ABMicrowaves/Project_1410/(list of files, drawings)

Other design files:
schematics/BA1410RX10R3_2.DSN
schematics/SOQPSK_TX_BB_A0P28.DSN
