ABMicrowaves/Project_1410/BA-BS-TLAB-DUALv-1.6/PIC18F24K22_registers.h

#byte TOSU = 0xFFF
#word TOS = 0xFFE
#byte STKPTR = 0xFFC
#bit    STKPTR0 = STKPTR.0
#bit    STKPTR1 = STKPTR.1
#bit    STKPTR2 = STKPTR.2
#bit    STKPTR3 = STKPTR.3
#bit    STKPTR4 = STKPTR.4
#bit    STKUNF = STKPTR.6
#bit    STKFUL = STKPTR.7
#byte PCLATU = 0xFFB
#byte PCLATH = 0xFFA
#byte PCL = 0xFF9
#byte TBLPTRU = 0xFF8
#word TBLPTR = 0xFF7
#byte TABLAT = 0xFF5
#word PROD = 0xFF4
#byte INTCON = 0xFF2
#bit    RBIF = INTCON.0
#bit    INT0IF = INTCON.1
#bit    TMR0IF = INTCON.2
#bit    RBIE = INTCON.3
#bit    INT0IE = INTCON.4
#bit    TMR0IE = INTCON.5
#bit    PEIE_GIEL = INTCON.6
#bit    GIE_GIEH = INTCON.7
#byte INTCON2 = 0xFF1
#bit    RBIP = INTCON2.0
#bit    TMR0IP = INTCON2.2
#bit    INTEDG2 = INTCON2.4
#bit    INTEDG1 = INTCON2.5
#bit    INTEDG0 = INTCON2.6
#bit    RBPU = INTCON2.7
#byte INTCON3 = 0xFF0
#bit    INT1IF = INTCON3.0
#bit    INT2IF = INTCON3.1
#bit    INT1IE = INTCON3.3
#bit    INT2IE = INTCON3.4
#bit    INT1IP = INTCON3.6
#bit    INT2IP = INTCON3.7
#byte INDF0 = 0xFEF
#byte POSTINC0 = 0xFEE
#byte POSTDEC0 = 0xFED
#byte PREINC0 = 0xFEC
#byte PLUSW0 = 0xFEB
#word FSR0 = 0xFEA
#byte WREG = 0xFE8
#byte INDF1 = 0xFE7
#byte POSTINC1 = 0xFE6
#byte POSTDEC1 = 0xFE5
#byte PREINC1 = 0xFE4
#byte PLUSW1 = 0xFE3
#word FSR1 = 0xFE2
#byte BSR = 0xFE0
#byte INDF2 = 0xFDF
#byte POSTINC2 = 0xFDE
#byte POSTDEC2 = 0xFDD
#byte PREINC2 = 0xFDC
#byte PLUSW2 = 0xFDB
#word FSR2 = 0xFDA
#byte STATUS = 0xFD8
#bit    C = STATUS.0
#bit    DC = STATUS.1
#bit    Z = STATUS.2
#bit    OV = STATUS.3
#bit    N = STATUS.4
#word TMR0 = 0xFD7
#byte T0CON = 0xFD5
#bit    T0PS0 = T0CON.0
#bit    T0PS1 = T0CON.1
#bit    T0PS2 = T0CON.2
#bit    PSA = T0CON.3
#bit    T0SE = T0CON.4
#bit    T0CS = T0CON.5
#bit    T08BIT = T0CON.6
#bit    TMR0ON = T0CON.7
#byte OSCCON = 0xFD3
#bit    SCS0 = OSCCON.0
#bit    SCS1 = OSCCON.1
#bit    HFIOFS = OSCCON.2
#bit    OSTS = OSCCON.3
#bit    IRCF0 = OSCCON.4
#bit    IRCF1 = OSCCON.5
#bit    IRCF2 = OSCCON.6
#bit    IDLEN = OSCCON.7
#byte OSCCON2 = 0xFD2
#bit    LFIOFS = OSCCON2.0
#bit    MFIOFS = OSCCON2.1
#bit    PRISD = OSCCON2.2
#bit    SOSCGO = OSCCON2.3
#bit    MFIOSEL = OSCCON2.4
#bit    SOSCRUN = OSCCON2.6
#bit    PLLRDY = OSCCON2.7
#byte WDTCON = 0xFD1
#bit    SWDTEN = WDTCON.0
#byte RCON = 0xFD0
#bit    BOR = RCON.0
#bit    POR = RCON.1
#bit    PD = RCON.2
#bit    TO = RCON.3
#bit    RI = RCON.4
#bit    SBOREN = RCON.6
#bit    IPEN = RCON.7
#word TMR1 = 0xFCF
#byte T1CON = 0xFCD
#bit    TMR1ON = T1CON.0
#bit    T1RD16 = T1CON.1
#bit    T1SYNC = T1CON.2
#bit    T1SOSCEN = T1CON.3
#bit    T1CKPS0 = T1CON.4
#bit    T1CKPS1 = T1CON.5
#bit    TMR1CS0 = T1CON.6
#bit    TMR1CS1 = T1CON.7
#byte T1GCON = 0xFCC
#bit    T1GSS0 = T1GCON.0
#bit    T1GSS1 = T1GCON.1
#bit    T1GVAL = T1GCON.2
#bit    T1GGO = T1GCON.3
#bit    T1GSPM = T1GCON.4
#bit    T1GTM = T1GCON.5
#bit    T1GPOL = T1GCON.6
#bit    TMR1GE = T1GCON.7
#byte SSP1CON3 = 0xFCB
#bit    SSP1DHEN = SSP1CON3.0
#bit    SSP1AHEN = SSP1CON3.1
#bit    SSP1SBCDE = SSP1CON3.2
#bit    SSP1SDAHT = SSP1CON3.3
#bit    SSP1BOEN = SSP1CON3.4
#bit    SSP1SCIE = SSP1CON3.5
#bit    SSP1PCIE = SSP1CON3.6
#bit    SSP1ACKTIM = SSP1CON3.7
#byte SSP1MSK = 0xFCA
#byte SSP1BUF = 0xFC9
#byte SSP1ADD = 0xFC8
#byte SSP1STAT = 0xFC7
#bit    SSP1BF = SSP1STAT.0
#bit    SSP1UA = SSP1STAT.1
#bit    SSP1R = SSP1STAT.2
#bit    SSP1S = SSP1STAT.3
#bit    SSP1P = SSP1STAT.4
#bit    SSP1D = SSP1STAT.5
#bit    SSP1CKE = SSP1STAT.6
#bit    SSP1SMP = SSP1STAT.7
#byte SSP1CON1 = 0xFC6
#bit    SSP1M0 = SSP1CON1.0
#bit    SSP1M1 = SSP1CON1.1
#bit    SSP1M2 = SSP1CON1.2
#bit    SSP1M3 = SSP1CON1.3
#bit    SSP1CKP = SSP1CON1.4
#bit    SSP1EN = SSP1CON1.5
#bit    SSP1OV = SSP1CON1.6
#bit    SSP1WCOL = SSP1CON1.7
#byte SSP1CON2 = 0xFC5
#bit    SSP1SEN = SSP1CON2.0
#bit    SSP1RSEN = SSP1CON2.1
#bit    SSP1PEN = SSP1CON2.2
#bit    SSP1RCEN = SSP1CON2.3
#bit    SSP1ACKEN = SSP1CON2.4
#bit    SSP1ACKDT = SSP1CON2.5
#bit    SSP1ACKSTAT = SSP1CON2.6
#bit    SSP1GCEN = SSP1CON2.7
#word ADRES = 0xFC4
#byte ADCON0 = 0xFC2
#bit    ADON = ADCON0.0
#bit    GO = ADCON0.1
#bit    CHS0 = ADCON0.2
#bit    CHS1 = ADCON0.3
#bit    CHS2 = ADCON0.4
#bit    CHS3 = ADCON0.5
#bit    CHS4 = ADCON0.6
#byte ADCON1 = 0xFC1
#bit    NVCFG0 = ADCON1.0
#bit    NVCFG1 = ADCON1.1
#bit    PVCFG0 = ADCON1.2
#bit    PVCFG1 = ADCON1.3
#bit    TRIGSEL = ADCON1.7
#byte ADCON2 = 0xFC0
#bit    ADCS0 = ADCON2.0
#bit    ADCS1 = ADCON2.1
#bit    ADCS2 = ADCON2.2
#bit    ACQT0 = ADCON2.3
#bit    ACQT1 = ADCON2.4
#bit    ACQT2 = ADCON2.5
#bit    ADFM = ADCON2.7
#word CCPR1 = 0xFBF
#byte CCP1CON = 0xFBD
#bit    CCP1M0 = CCP1CON.0
#bit    CCP1M1 = CCP1CON.1
#bit    CCP1M2 = CCP1CON.2
#bit    CCP1M3 = CCP1CON.3
#bit    DC1B0 = CCP1CON.4
#bit    DC1B1 = CCP1CON.5
#bit    P1M0 = CCP1CON.6
#bit    P1M1 = CCP1CON.7
#byte TMR2 = 0xFBC
#byte PR2 = 0xFBB
#byte T2CON = 0xFBA
#bit    T2CKPS0 = T2CON.0
#bit    T2CKPS1 = T2CON.1
#bit    TMR2ON = T2CON.2
#bit    T2OUTPS0 = T2CON.3
#bit    T2OUTPS1 = T2CON.4
#bit    T2OUTPS2 = T2CON.5
#bit    T2OUTPS3 = T2CON.6
#byte PSTR1CON = 0xFB9
#bit    STR1A = PSTR1CON.0
#bit    STR1B = PSTR1CON.1
#bit    STR1C = PSTR1CON.2
#bit    STR1D = PSTR1CON.3
#bit    STR1SYNC = PSTR1CON.4
#byte BAUDCON1 = 0xFB8
#bit    ABDEN1 = BAUDCON1.0
#bit    WUE1 = BAUDCON1.1
#bit    BRG161 = BAUDCON1.3
#bit    CKTXP1 = BAUDCON1.4
#bit    DTRXP1 = BAUDCON1.5
#bit    RCIDL1 = BAUDCON1.6
#bit    ABDOVF1 = BAUDCON1.7
#byte PWM1CON = 0xFB7
#bit    P1DC0 = PWM1CON.0
#bit    P1DC1 = PWM1CON.1
#bit    P1DC2 = PWM1CON.2
#bit    P1DC3 = PWM1CON.3
#bit    P1DC4 = PWM1CON.4
#bit    P1DC5 = PWM1CON.5
#bit    P1DC6 = PWM1CON.6
#bit    P1RSEN = PWM1CON.7
#byte ECCP1AS = 0xFB6
#bit    PSS1BD0 = ECCP1AS.0
#bit    PSS1BD1 = ECCP1AS.1
#bit    PSS1AC0 = ECCP1AS.2
#bit    PSS1AC1 = ECCP1AS.3
#bit    CCP1AS0 = ECCP1AS.4
#bit    CCP1AS1 = ECCP1AS.5
#bit    CCP1AS2 = ECCP1AS.6
#bit    CCP1ASE = ECCP1AS.7
#byte T3GCON = 0xFB4
#bit    T3GSS0 = T3GCON.0
#bit    T3GSS1 = T3GCON.1
#bit    T3GVAL = T3GCON.2
#bit    T3GGO = T3GCON.3
#bit    T3GSPM = T3GCON.4
#bit    T3GTM = T3GCON.5
#bit    T3GPOL = T3GCON.6
#bit    TMR3GE = T3GCON.7
#word TMR3 = 0xFB3
#byte T3CON = 0xFB1
#bit    TMR3ON = T3CON.0
#bit    T3RD16 = T3CON.1
#bit    T3SYNC = T3CON.2
#bit    T3SOSCEN = T3CON.3
#bit    T3CKPS0 = T3CON.4
#bit    T3CKPS1 = T3CON.5
#bit    TMR3CS0 = T3CON.6
#bit    TMR3CS1 = T3CON.7
#byte SPBRGH1 = 0xFB0
#byte SPBRG1 = 0xFAF
#byte RCREG1 = 0xFAE
#byte TXREG1 = 0xFAD
#byte TXSTA1 = 0xFAC
#bit    TX9D1 = TXSTA1.0
#bit    TRMT1 = TXSTA1.1
#bit    BRGH1 = TXSTA1.2
#bit    SENDB1 = TXSTA1.3
#bit    SYNC1 = TXSTA1.4
#bit    TXEN1 = TXSTA1.5
#bit    TX91 = TXSTA1.6
#bit    CSRC1 = TXSTA1.7
#byte RCSTA1 = 0xFAB
#bit    RX9D1 = RCSTA1.0
#bit    OERR1 = RCSTA1.1
#bit    FERR1 = RCSTA1.2
#bit    ADDEN1 = RCSTA1.3
#bit    CREN1 = RCSTA1.4
#bit    SREN1 = RCSTA1.5
#bit    RX91 = RCSTA1.6
#bit    SPEN1 = RCSTA1.7
#byte EEADR = 0xFA9
#byte EEDATA = 0xFA8
#byte EECON2 = 0xFA7
#byte EECON1 = 0xFA6
#bit    RD = EECON1.0
#bit    WR = EECON1.1
#bit    WREN = EECON1.2
#bit    WRERR = EECON1.3
#bit    FREE = EECON1.4
#bit    CFGS = EECON1.6
#bit    EEPGD = EECON1.7
#byte IPR3 = 0xFA5
#bit    TMR1GIP = IPR3.0
#bit    TMR3GIP = IPR3.1
#bit    TMR5GIP = IPR3.2
#bit    CTMUIP = IPR3.3
#bit    TX2IP = IPR3.4
#bit    RC2IP = IPR3.5
#bit    BCL2IP = IPR3.6
#bit    SSP2IP = IPR3.7
#byte PIR3 = 0xFA4
#bit    TMR1GIF = PIR3.0
#bit    TMR3GIF = PIR3.1
#bit    TMR5GIF = PIR3.2
#bit    CTMUIF = PIR3.3
#bit    TX2IF = PIR3.4
#bit    RC2IF = PIR3.5
#bit    BCL2IF = PIR3.6
#bit    SSP2IF = PIR3.7
#byte PIE3 = 0xFA3
#bit    TMR1GIE = PIE3.0
#bit    TMR3GIE = PIE3.1
#bit    TMR5GIE = PIE3.2
#bit    CTMUIE = PIE3.3
#bit    TX2IE = PIE3.4
#bit    RC2IE = PIE3.5
#bit    BCL2IE = PIE3.6
#bit    SSP2IE = PIE3.7
#byte IPR2 = 0xFA2
#bit    CCP2IP = IPR2.0
#bit    TMR3IP = IPR2.1
#bit    HLVDIP = IPR2.2
#bit    BCL1IP = IPR2.3
#bit    EEIP = IPR2.4
#bit    C2IP = IPR2.5
#bit    C1IP = IPR2.6
#bit    OSCFIP = IPR2.7
#byte PIR2 = 0xFA1
#bit    CCP2IF = PIR2.0
#bit    TMR3IF = PIR2.1
#bit    HLVDIF = PIR2.2
#bit    BCL1IF = PIR2.3
#bit    EEIF = PIR2.4
#bit    C2IF = PIR2.5
#bit    C1IF = PIR2.6
#bit    OSCFIF = PIR2.7
#byte PIE2 = 0xFA0
#bit    CCP2IE = PIE2.0
#bit    TMR3IE = PIE2.1
#bit    HLVDIE = PIE2.2
#bit    BCL1IE = PIE2.3
#bit    EEIE = PIE2.4
#bit    C2IE = PIE2.5
#bit    C1IE = PIE2.6
#bit    OSCFIE = PIE2.7
#byte IPR1 = 0xF9F
#bit    TMR1IP = IPR1.0
#bit    TMR2IP = IPR1.1
#bit    CCP1IP = IPR1.2
#bit    SSP1IP = IPR1.3
#bit    TX1IP = IPR1.4
#bit    RC1IP = IPR1.5
#bit    ADIP = IPR1.6
#byte PIR1 = 0xF9E
#bit    TMR1IF = PIR1.0
#bit    TMR2IF = PIR1.1
#bit    CCP1IF = PIR1.2
#bit    SSP1IF = PIR1.3
#bit    TX1IF = PIR1.4
#bit    RC1IF = PIR1.5
#bit    ADIF = PIR1.6
#byte PIE1 = 0xF9D
#bit    TMR1IE = PIE1.0
#bit    TMR2IE = PIE1.1
#bit    CCP1IE = PIE1.2
#bit    SSP1IE = PIE1.3
#bit    TX1IE = PIE1.4
#bit    RC1IE = PIE1.5
#bit    ADIE = PIE1.6
#byte HLVDCON = 0xF9C
#bit    HLVDL0 = HLVDCON.0
#bit    HLVDL1 = HLVDCON.1
#bit    HLVDL2 = HLVDCON.2
#bit    HLVDL3 = HLVDCON.3
#bit    HLVDEN = HLVDCON.4
#bit    IRVST = HLVDCON.5
#bit    BGVST = HLVDCON.6
#bit    VDIRMAG = HLVDCON.7
#byte OSCTUNE = 0xF9B
#bit    TUN0 = OSCTUNE.0
#bit    TUN1 = OSCTUNE.1
#bit    TUN2 = OSCTUNE.2
#bit    TUN3 = OSCTUNE.3
#bit    TUN4 = OSCTUNE.4
#bit    TUN5 = OSCTUNE.5
#bit    PLLEN = OSCTUNE.6
#bit    INTSRC = OSCTUNE.7
#byte TRISE = 0xF96
#bit    WPUE3 = TRISE.7
#byte TRISC = 0xF94
#byte TRISB = 0xF93
#byte TRISA = 0xF92
#byte LATC = 0xF8B
#byte LATB = 0xF8A
#byte LATA = 0xF89
#byte PORTE = 0xF84
#bit    RE3 = PORTE.3
#byte PORTC = 0xF82
#byte PORTB = 0xF81
#byte PORTA = 0xF80
#byte IPR5 = 0xF7F
#bit    TMR4IP = IPR5.0
#bit    TMR5IP = IPR5.1
#bit    TMR6IP = IPR5.2
#byte PIR5 = 0xF7E
#bit    TMR4IF = PIR5.0
#bit    TMR5IF = PIR5.1
#bit    TMR6IF = PIR5.2
#byte PIE5 = 0xF7D
#bit    TMR4IE = PIE5.0
#bit    TMR5IE = PIE5.1
#bit    TMR6IE = PIE5.2
#byte IPR4 = 0xF7C
#bit    CCP3IP = IPR4.0
#bit    CCP4IP = IPR4.1
#bit    CCP5IP = IPR4.2
#byte PIR4 = 0xF7B
#bit    CCP3IF = PIR4.0
#bit    CCP4IF = PIR4.1
#bit    CCP5IF = PIR4.2
#byte PIE4 = 0xF7A
#bit    CCP3IE = PIE4.0
#bit    CCP4IE = PIE4.1
#bit    CCP5IE = PIE4.2
#byte CM1CON0 = 0xF79
#bit    C1CH0 = CM1CON0.0
#bit    C1CH1 = CM1CON0.1
#bit    C1R = CM1CON0.2
#bit    C1SP = CM1CON0.3
#bit    C1POL = CM1CON0.4
#bit    C1OE = CM1CON0.5
//#bit    C1OUT = CM1CON0.6
#bit    C1ON = CM1CON0.7
#byte CM2CON0 = 0xF78
#bit    C2CH0 = CM2CON0.0
#bit    C2CH1 = CM2CON0.1
#bit    C2R = CM2CON0.2
#bit    C2SP = CM2CON0.3
#bit    C2POL = CM2CON0.4
#bit    C2OE = CM2CON0.5
//#bit    C2OUT = CM2CON0.6
#bit    C2ON = CM2CON0.7
#byte CM2CON1 = 0xF77
#bit    C2SYNC = CM2CON1.0
#bit    C1SYNC = CM2CON1.1
#bit    C2HYS = CM2CON1.2
#bit    C1HYS = CM2CON1.3
#bit    C2RSEL = CM2CON1.4
#bit    C1RSEL = CM2CON1.5
#bit    MC2OUT = CM2CON1.6
#bit    MC1OUT = CM2CON1.7
#byte SPBRGH2 = 0xF76
#byte SPBRG2 = 0xF75
#byte RCREG2 = 0xF74
#byte TXREG2 = 0xF73
#byte TXSTA2 = 0xF72
#bit    TX9D2 = TXSTA2.0
#bit    TRMT2 = TXSTA2.1
#bit    BRGH2 = TXSTA2.2
#bit    SENDB2 = TXSTA2.3
#bit    SYNC2 = TXSTA2.4
#bit    TXEN2 = TXSTA2.5
#bit    TX92 = TXSTA2.6
#bit    CSRC2 = TXSTA2.7
#byte RCSTA2 = 0xF71
#bit    RX9D2 = RCSTA2.0
#bit    OERR2 = RCSTA2.1
#bit    FERR2 = RCSTA2.2
#bit    ADDEN2 = RCSTA2.3
#bit    CREN2 = RCSTA2.4
#bit    SREN2 = RCSTA2.5
#bit    RX92 = RCSTA2.6
#bit    SPEN2 = RCSTA2.7
#byte BAUDCON2 = 0xF70
#bit    ABDEN2 = BAUDCON2.0
#bit    WUE2 = BAUDCON2.1
#bit    BRG162 = BAUDCON2.3
#bit    CKTXP2 = BAUDCON2.4
#bit    DTRXP2 = BAUDCON2.5
#bit    RCIDL2 = BAUDCON2.6
#bit    ABDOVF2 = BAUDCON2.7
#byte SSP2BUF = 0xF6F
#byte SSP2ADD = 0xF6E
#byte SSP2STAT = 0xF6D
#bit    SSP2BF = SSP2STAT.0
#bit    SSP2UA = SSP2STAT.1
#bit    SSP2R = SSP2STAT.2
#bit    SSP2S = SSP2STAT.3
#bit    SSP2P = SSP2STAT.4
#bit    SSP2D = SSP2STAT.5
#bit    SSP2CKE = SSP2STAT.6
#bit    SSP2SMP = SSP2STAT.7
#byte SSP2CON1 = 0xF6C
#bit    SSP2M0 = SSP2CON1.0
#bit    SSP2M1 = SSP2CON1.1
#bit    SSP2M2 = SSP2CON1.2
#bit    SSP2M3 = SSP2CON1.3
#bit    SSP2CKP = SSP2CON1.4
#bit    SSP2EN = SSP2CON1.5
#bit    SSP2OV = SSP2CON1.6
#bit    SSP2WCOL = SSP2CON1.7
#byte SSP2CON2 = 0xF6B
#bit    SSP2SEN = SSP2CON2.0
#bit    SSP2RSEN = SSP2CON2.1
#bit    SSP2PEN = SSP2CON2.2
#bit    SSP2RCEN = SSP2CON2.3
#bit    SSP2ACKEN = SSP2CON2.4
#bit    SSP2ACKDT = SSP2CON2.5
#bit    SSP2ACKSTAT = SSP2CON2.6
#bit    SSP2GCEN = SSP2CON2.7
#byte SSP2MSK = 0xF6A
#byte SSP2CON3 = 0xF69
#bit    SSP2DHEN = SSP2CON3.0
#bit    SSP2AHEN = SSP2CON3.1
#bit    SSP2SBCDE = SSP2CON3.2
#bit    SSP2SDAHT = SSP2CON3.3
#bit    SSP2BOEN = SSP2CON3.4
#bit    SSP2SCIE = SSP2CON3.5
#bit    SSP2PCIE = SSP2CON3.6
#bit    SSP2ACKTIM = SSP2CON3.7
#word CCPR2 = 0xF68
#byte CCP2CON = 0xF66
#bit    CCP2M0 = CCP2CON.0
#bit    CCP2M1 = CCP2CON.1
#bit    CCP2M2 = CCP2CON.2
#bit    CCP2M3 = CCP2CON.3
#bit    DC2B0 = CCP2CON.4
#bit    DC2B1 = CCP2CON.5
#bit    P2M0 = CCP2CON.6
#bit    P2M1 = CCP2CON.7
#byte PWM2CON = 0xF65
#bit    P2DC0 = PWM2CON.0
#bit    P2DC1 = PWM2CON.1
#bit    P2DC2 = PWM2CON.2
#bit    P2DC3 = PWM2CON.3
#bit    P2DC4 = PWM2CON.4
#bit    P2DC5 = PWM2CON.5
#bit    P2DC6 = PWM2CON.6
#bit    P2RSEN = PWM2CON.7
#byte ECCP2AS = 0xF64
#bit    PSS2BD0 = ECCP2AS.0
#bit    PSS2BD1 = ECCP2AS.1
#bit    PSS2AC0 = ECCP2AS.2
#bit    PSS2AC1 = ECCP2AS.3
#bit    CCP2AS0 = ECCP2AS.4
#bit    CCP2AS1 = ECCP2AS.5
#bit    CCP2AS2 = ECCP2AS.6
#bit    CCP2ASE = ECCP2AS.7
#byte PSTR2CON = 0xF63
#bit    STR2A = PSTR2CON.0
#bit    STR2B = PSTR2CON.1
#bit    STR2C = PSTR2CON.2
#bit    STR2D = PSTR2CON.3
#bit    STR2SYNC = PSTR2CON.4
#byte IOCB = 0xF62
#bit    IOCB4 = IOCB.4
#bit    IOCB5 = IOCB.5
#bit    IOCB6 = IOCB.6
#bit    IOCB7 = IOCB.7
#byte WPUB = 0xF61
#byte SLRCON = 0xF60
#bit    SLRA = SLRCON.0
#bit    SLRB = SLRCON.1
#bit    SLRC = SLRCON.2
#word CCPR3 = 0xF5F
#byte CCP3CON = 0xF5D
#bit    CCP3M0 = CCP3CON.0
#bit    CCP3M1 = CCP3CON.1
#bit    CCP3M2 = CCP3CON.2
#bit    CCP3M3 = CCP3CON.3
#bit    DC3B0 = CCP3CON.4
#bit    DC3B1 = CCP3CON.5
#bit    P3M0 = CCP3CON.6
#bit    P3M1 = CCP3CON.7
#byte PWM3CON = 0xF5C
#bit    P3DC0 = PWM3CON.0
#bit    P3DC1 = PWM3CON.1
#bit    P3DC2 = PWM3CON.2
#bit    P3DC3 = PWM3CON.3
#bit    P3DC4 = PWM3CON.4
#bit    P3DC5 = PWM3CON.5
#bit    P3DC6 = PWM3CON.6
#bit    P3RSEN = PWM3CON.7
#byte ECCP3AS = 0xF5B
#bit    PSS3BD0 = ECCP3AS.0
#bit    PSS3BD1 = ECCP3AS.1
#bit    PSS3AC0 = ECCP3AS.2
#bit    PSS3AC1 = ECCP3AS.3
#bit    CCP3AS0 = ECCP3AS.4
#bit    CCP3AS1 = ECCP3AS.5
#bit    CCP3AS2 = ECCP3AS.6
#bit    CCP3ASE = ECCP3AS.7
#byte PSTR3CON = 0xF5A
#bit    STR3A = PSTR3CON.0
#bit    STR3B = PSTR3CON.1
#bit    STR3C = PSTR3CON.2
#bit    STR3D = PSTR3CON.3
#bit    STR3SYNC = PSTR3CON.4
#word CCPR4 = 0xF59
#byte CCP4CON = 0xF57
#bit    CCP4M0 = CCP4CON.0
#bit    CCP4M1 = CCP4CON.1
#bit    CCP4M2 = CCP4CON.2
#bit    CCP4M3 = CCP4CON.3
#bit    DC4B0 = CCP4CON.4
#bit    DC4B1 = CCP4CON.5
#word CCPR5 = 0xF56
#byte CCP5CON = 0xF54
#bit    CCP5M0 = CCP5CON.0
#bit    CCP5M1 = CCP5CON.1
#bit    CCP5M2 = CCP5CON.2
#bit    CCP5M3 = CCP5CON.3
#bit    DC5B0 = CCP5CON.4
#bit    DC5B1 = CCP5CON.5
#byte TMR4 = 0xF53
#byte PR4 = 0xF52
#byte T4CON = 0xF51
#bit    T4CKPS0 = T4CON.0
#bit    T4CKPS1 = T4CON.1
#bit    TMR4ON = T4CON.2
#bit    T4OUTPS0 = T4CON.3
#bit    T4OUTPS1 = T4CON.4
#bit    T4OUTPS2 = T4CON.5
#bit    T4OUTPS3 = T4CON.6
#word TMR5 = 0xF50
#byte T5CON = 0xF4E
#bit    TMR5ON = T5CON.0
#bit    T5RD16 = T5CON.1
#bit    T5SYNC = T5CON.2
#bit    T5SOSCEN = T5CON.3
#bit    T5CKPS0 = T5CON.4
#bit    T5CKPS1 = T5CON.5
#bit    TMR5CS0 = T5CON.6
#bit    TMR5CS1 = T5CON.7
#byte T5GCON = 0xF4D
#bit    T5GSS0 = T5GCON.0
#bit    T5GSS1 = T5GCON.1
#bit    T5GVAL = T5GCON.2
#bit    T5GGO = T5GCON.3
#bit    T5GSPM = T5GCON.4
#bit    T5GTM = T5GCON.5
#bit    T5GPOL = T5GCON.6
#bit    TMR5GE = T5GCON.7
#byte TMR6 = 0xF4C
#byte PR6 = 0xF4B
#byte T6CON = 0xF4A
#bit    T6CKPS0 = T6CON.0
#bit    T6CKPS1 = T6CON.1
#bit    TMR6ON = T6CON.2
#bit    T6OUTPS0 = T6CON.3
#bit    T6OUTPS1 = T6CON.4
#bit    T6OUTPS2 = T6CON.5
#bit    T6OUTPS3 = T6CON.6
#byte CCPTMRS0 = 0xF49
#bit    C1TSEL0 = CCPTMRS0.0
#bit    C1TSEL1 = CCPTMRS0.1
#bit    C2TSEL0 = CCPTMRS0.3
#bit    C2TSEL1 = CCPTMRS0.4
#bit    C3TSEL0 = CCPTMRS0.6
#bit    C3TSEL1 = CCPTMRS0.7
#byte CCPTMRS1 = 0xF48
#bit    C4TSEL0 = CCPTMRS1.0
#bit    C4TSEL1 = CCPTMRS1.1
#bit    C5TSEL0 = CCPTMRS1.2
#bit    C5TSEL1 = CCPTMRS1.3
#byte SRCON0 = 0xF47
#bit    SRPR = SRCON0.0
#bit    SRPS = SRCON0.1
#bit    SRNQEN = SRCON0.2
#bit    SRQEN = SRCON0.3
#bit    SRCLK0 = SRCON0.4
#bit    SRCLK1 = SRCON0.5
#bit    SRCLK2 = SRCON0.6
#bit    SRLEN = SRCON0.7
#byte SRCON1 = 0xF46
#bit    SRRC1E = SRCON1.0
#bit    SRRC2E = SRCON1.1
#bit    SRRCKE = SRCON1.2
#bit    SRRPE = SRCON1.3
#bit    SRSC1E = SRCON1.4
#bit    SRSC2E = SRCON1.5
#bit    SRSCKE = SRCON1.6
#bit    SRSPE = SRCON1.7
#word CTMUCON = 0xF45
#byte CTMUICON = 0xF43
#bit    IRNG0 = CTMUICON.0
#bit    IRNG1 = CTMUICON.1
#bit    ITRIM0 = CTMUICON.2
#bit    ITRIM1 = CTMUICON.3
#bit    ITRIM2 = CTMUICON.4
#bit    ITRIM3 = CTMUICON.5
#bit    ITRIM4 = CTMUICON.6
#bit    ITRIM5 = CTMUICON.7
#byte VREFCON0 = 0xF42
#bit    FVRS0 = VREFCON0.4
#bit    FVRS1 = VREFCON0.5
#bit    FVRST = VREFCON0.6
#bit    FVREN = VREFCON0.7
#byte VREFCON1 = 0xF41
#bit    DACNSS = VREFCON1.0
#bit    DACPSS0 = VREFCON1.2
#bit    DACPSS1 = VREFCON1.3
#bit    DACOE = VREFCON1.5
#bit    DACLPS = VREFCON1.6
#bit    DACEN = VREFCON1.7
#byte VREFCON2 = 0xF40
#byte PMD0 = 0xF3F
#bit    TMR1MD = PMD0.0
#bit    TMR2MD = PMD0.1
#bit    TMR3MD = PMD0.2
#bit    TMR4MD = PMD0.3
#bit    TMR5MD = PMD0.4
#bit    TMR6MD = PMD0.5
#bit    UART1MD = PMD0.6
#bit    UART2MD = PMD0.7
#byte PMD1 = 0xF3E
#bit    CCP1MD = PMD1.0
#bit    CCP2MD = PMD1.1
#bit    CCP3MD = PMD1.2
#bit    CCP4MD = PMD1.3
#bit    CCP5MD = PMD1.4
#bit    MSSP1MD = PMD1.6
#bit    MSSP2MD = PMD1.7
#byte PMD2 = 0xF3D
#bit    ADCMD = PMD2.0
#bit    CMP1MD = PMD2.1
#bit    CMP2MD = PMD2.2
#bit    CTMUMD = PMD2.3
#byte ANSELC = 0xF3A
#bit    ANSC2 = ANSELC.2
#bit    ANSC3 = ANSELC.3
#bit    ANSC4 = ANSELC.4
#bit    ANSC5 = ANSELC.5
#bit    ANSC6 = ANSELC.6
#bit    ANSC7 = ANSELC.7
#byte ANSELB = 0xF39
#byte ANSELA = 0xF38
#bit    ANSA0 = ANSELA.0
#bit    ANSA1 = ANSELA.1
#bit    ANSA2 = ANSELA.2
#bit    ANSA3 = ANSELA.3
#bit    ANSA5 = ANSELA.5
