ABMicrowaves/Project_1410/BA-BS-TLAB-DUALv-1.6/24FJ128GB110_registers.h

#word WREG0 = 0x000

#word WREG1 = 0x002

#word WREG2 = 0x004

#word WREG3 = 0x006

#word WREG4 = 0x008

#word WREG5 = 0x00A

#word WREG6 = 0x00C

#word WREG7 = 0x00E

#word WREG8 = 0x010

#word WREG9 = 0x012

#word WREG10 = 0x014

#word WREG11 = 0x016

#word WREG12 = 0x018

#word WREG13 = 0x01A

#word WREG14 = 0x01C

#word WREG15 = 0x01E

#word SPLIM = 0x020

#word PCL = 0x02E

#word PCH = 0x030

#word TBLPAG = 0x032

#word PSVPAG = 0x034

#word RCOUNT = 0x036

union  {
      struct {
         unsigned int C:1;
         unsigned int Z:1;
         unsigned int OV:1;
         unsigned int N:1;
         unsigned int RA:1;
         unsigned int IPL0:1;
         unsigned int IPL1:1;
         unsigned int IPL2:1;
         unsigned int DC:1;
      };
      struct {
         unsigned int :1;
         unsigned int :1;
         unsigned int :1;
         unsigned int :1;
         unsigned int :1;
         unsigned int IPL:3;
         unsigned int :1;
      };
} SR;
#word SR = 0x042

struct  {
   unsigned int :2;
   unsigned int PSV:1;
   unsigned int IPL3:1;
} CORCON;
#word CORCON = 0x044

#word DISICNT = 0x052

struct  {
   unsigned int CN0PDE:1;
   unsigned int CN1PDE:1;
   unsigned int CN2PDE:1;
   unsigned int CN3PDE:1;
   unsigned int CN4PDE:1;
   unsigned int CN5PDE:1;
   unsigned int CN6PDE:1;
   unsigned int CN7PDE:1;
   unsigned int CN8PDE:1;
   unsigned int CN9PDE:1;
   unsigned int CN10PDE:1;
   unsigned int CN11PDE:1;
   unsigned int CN12PDE:1;
   unsigned int CN13PDE:1;
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
} INTCON1;
#word INTCON1 = 0x080

struct  {
   unsigned int INT0EP:1;
   unsigned int INT1EP:1;
   unsigned int INT2EP:1;
   unsigned int INT3EP:1;
   unsigned int INT4EP:1;
   unsigned int :9;
   unsigned int DISI:1;
   unsigned int ALTIVT:1;
} INTCON2;
#word INTCON2 = 0x082

struct  {
   unsigned int INT0IF:1;
   unsigned int IC1IF:1;
   unsigned int OC1IF:1;
   unsigned int T1IF:1;
   unsigned int :1;
   unsigned int IC2IF:1;
   unsigned int OC2IF:1;
   unsigned int T2IF:1;
   unsigned int T3IF:1;
   unsigned int SPF1IF:1;
   unsigned int SPI1IF:1;
   unsigned int U1RXIF:1;
   unsigned int U1TXIF:1;
   unsigned int AD1IF:1;
} IFS0;
#word IFS0 = 0x084

struct  {
   unsigned int SI2C1IF:1;
   unsigned int MI2C1IF:1;
   unsigned int CMIF:1;
   unsigned int CNIF:1;
   unsigned int INT1IF:1;
   unsigned int :1;
   unsigned int IC7IF:1;
   unsigned int IC8IF:1;
   unsigned int :1;
   unsigned int OC3IF:1;
   unsigned int OC4IF:1;
   unsigned int T4IF:1;
   unsigned int T5IF:1;
   unsigned int INT2IF:1;
   unsigned int U2RXIF:1;
   unsigned int U2TXIF:1;
} IFS1;
#word IFS1 = 0x086

struct  {
   unsigned int SPF2IF:1;
   unsigned int SPI2IF:1;
   unsigned int :3;
   unsigned int IC3IF:1;
   unsigned int IC4IF:1;
   unsigned int IC5IF:1;
   unsigned int IC6IF:1;
   unsigned int OC5IF:1;
   unsigned int OC6IF:1;
   unsigned int OC7IF:1;
   unsigned int OC8IF:1;
   unsigned int PMPIF:1;
} IFS2;
#word IFS2 = 0x088

struct  {
   unsigned int :1;
   unsigned int SI2C2IF:1;
   unsigned int MI2C2IF:1;
   unsigned int :2;
   unsigned int INT3IF:1;
   unsigned int INT4IF:1;
   unsigned int :7;
   unsigned int RTCIF:1;
} IFS3;
#word IFS3 = 0x08A

struct  {
   unsigned int :1;
   unsigned int U1ERIF:1;
   unsigned int U2ERIF:1;
   unsigned int CRCIF:1;
   unsigned int :4;
   unsigned int LVDIF:1;
   unsigned int :4;
   unsigned int CTMUIF:1;
} IFS4;
#word IFS4 = 0x08C

struct  {
   unsigned int :1;
   unsigned int U3ERIF:1;
   unsigned int U3RXIF:1;
   unsigned int U3TXIF:1;
   unsigned int SI2C3IF:1;
   unsigned int MI2C3IF:1;
   unsigned int USB1IF:1;
   unsigned int U4ERIF:1;
   unsigned int U4RXIF:1;
   unsigned int U4TXIF:1;
   unsigned int SPF3IF:1;
   unsigned int SPI3IF:1;
   unsigned int OC9IF:1;
   unsigned int IC9IF:1;
} IFS5;
#word IFS5 = 0x08E

struct  {
   unsigned int INT0IE:1;
   unsigned int IC1IE:1;
   unsigned int OC1IE:1;
   unsigned int T1IE:1;
   unsigned int :1;
   unsigned int IC2IE:1;
   unsigned int OC2IE:1;
   unsigned int T2IE:1;
   unsigned int T3IE:1;
   unsigned int SPF1IE:1;
   unsigned int SPI1IE:1;
   unsigned int U1RXIE:1;
   unsigned int U1TXIE:1;
   unsigned int AD1IE:1;
} IEC0;
#word IEC0 = 0x094

struct  {
   unsigned int SI2C1IE:1;
   unsigned int MI2C1IE:1;
   unsigned int CMIE:1;
   unsigned int CNIE:1;
   unsigned int INT1IE:1;
   unsigned int :1;
   unsigned int IC7IE:1;
   unsigned int IC8IE:1;
   unsigned int :1;
   unsigned int OC3IE:1;
   unsigned int OC4IE:1;
   unsigned int T4IE:1;
   unsigned int T5IE:1;
   unsigned int INT2IE:1;
   unsigned int U2RXIE:1;
   unsigned int U2TXIE:1;
} IEC1;
#word IEC1 = 0x096

struct  {
   unsigned int SPF2IE:1;
   unsigned int SPI2IE:1;
   unsigned int :3;
   unsigned int IC3IE:1;
   unsigned int IC4IE:1;
   unsigned int IC5IE:1;
   unsigned int IC6IE:1;
   unsigned int OC5IE:1;
   unsigned int OC6IE:1;
   unsigned int OC7IE:1;
   unsigned int OC8IE:1;
   unsigned int PMPIE:1;
} IEC2;
#word IEC2 = 0x098

struct  {
   unsigned int :1;
   unsigned int SI2C2IE:1;
   unsigned int MI2C2IE:1;
   unsigned int :2;
   unsigned int INT3IE:1;
   unsigned int INT4IE:1;
   unsigned int :7;
   unsigned int RTCIE:1;
} IEC3;
#word IEC3 = 0x09A

struct  {
   unsigned int :1;
   unsigned int U1ERIE:1;
   unsigned int U2ERIE:1;
   unsigned int CRCIE:1;
   unsigned int :4;
   unsigned int LVDIE:1;
   unsigned int :4;
   unsigned int CTMUIE:1;
} IEC4;
#word IEC4 = 0x09C

struct  {
   unsigned int :1;
   unsigned int U3ERIE:1;
   unsigned int U3RXIE:1;
   unsigned int U3TXIE:1;
   unsigned int SI2C3IE:1;
   unsigned int MI2C3IE:1;
   unsigned int USB1IE:1;
   unsigned int U4ERIE:1;
   unsigned int U4RXIE:1;
   unsigned int U4TXIE:1;
   unsigned int SPF3IE:1;
   unsigned int SPI3IE:1;
   unsigned int OC9IE:1;
   unsigned int IC9IE:1;
} IEC5;
#word IEC5 = 0x09E

union  {
      struct {
         unsigned int INT0IP0:1;
         unsigned int INT0IP1:1;
         unsigned int INT0IP2:1;
         unsigned int :1;
         unsigned int IC1IP0:1;
         unsigned int IC1IP1:1;
         unsigned int IC1IP2:1;
         unsigned int :1;
         unsigned int OC1IP0:1;
         unsigned int OC1IP1:1;
         unsigned int OC1IP2:1;
         unsigned int :1;
         unsigned int T1IP0:1;
         unsigned int T1IP1:1;
         unsigned int T1IP2:1;
      };
      struct {
         unsigned int INT0IP:3;
         unsigned int :1;
         unsigned int IC1IP:3;
         unsigned int :1;
         unsigned int OC1IP:3;
         unsigned int :1;
         unsigned int T1IP:3;
      };
} IPC0;
#word IPC0 = 0x0A4

union  {
      struct {
         unsigned int :4;
         unsigned int IC2IP0:1;
         unsigned int IC2IP1:1;
         unsigned int IC2IP2:1;
         unsigned int :1;
         unsigned int OC2IP0:1;
         unsigned int OC2IP1:1;
         unsigned int OC2IP2:1;
         unsigned int :1;
         unsigned int T2IP0:1;
         unsigned int T2IP1:1;
         unsigned int T2IP2:1;
      };
      struct {
         unsigned int :4;
         unsigned int IC2IP:3;
         unsigned int :1;
         unsigned int OC2IP:3;
         unsigned int :1;
         unsigned int T2IP:3;
      };
} IPC1;
#word IPC1 = 0x0A6

union  {
      struct {
         unsigned int T3IP0:1;
         unsigned int T3IP1:1;
         unsigned int T3IP2:1;
         unsigned int :1;
         unsigned int SPF1IP0:1;
         unsigned int SPF1IP1:1;
         unsigned int SPF1IP2:1;
         unsigned int :1;
         unsigned int SPI1IP0:1;
         unsigned int SPI1IP1:1;
         unsigned int SPI1IP2:1;
         unsigned int :1;
         unsigned int U1RXIP0:1;
         unsigned int U1RXIP1:1;
         unsigned int U1RXIP2:1;
      };
      struct {
         unsigned int T3IP:3;
         unsigned int :1;
         unsigned int SPF1IP:3;
         unsigned int :1;
         unsigned int SPI1IP:3;
         unsigned int :1;
         unsigned int U1RXIP:3;
      };
} IPC2;
#word IPC2 = 0x0A8

union  {
      struct {
         unsigned int U1TXIP0:1;
         unsigned int U1TXIP1:1;
         unsigned int U1TXIP2:1;
         unsigned int :1;
         unsigned int AD1IP0:1;
         unsigned int AD1IP1:1;
         unsigned int AD1IP2:1;
      };
      struct {
         unsigned int U1TXIP:3;
         unsigned int :1;
         unsigned int AD1IP:3;
      };
} IPC3;
#word IPC3 = 0x0AA

union  {
   union {
      struct {
         unsigned int SI2C1P0:1;
         unsigned int SI2C1P1:1;
         unsigned int SI2C1P2:1;
         unsigned int :1;
         unsigned int MI2C1P0:1;
         unsigned int MI2C1P1:1;
         unsigned int MI2C1P2:1;
         unsigned int :1;
         unsigned int CMIP0:1;
         unsigned int CMIP1:1;
         unsigned int CMIP2:1;
         unsigned int :1;
         unsigned int CNIP0:1;
         unsigned int CNIP1:1;
         unsigned int CNIP2:1;
      };
      struct {
         unsigned int SI2C1P:3;
         unsigned int :1;
         unsigned int MI2C1P:3;
         unsigned int :1;
         unsigned int CMIP:3;
         unsigned int :1;
         unsigned int CNIP:3;
      };

   union {
      struct {
         unsigned int SI2C1IP0:1;
         unsigned int SI2C1IP1:1;
         unsigned int SI2C1IP2:1;
         unsigned int :1;
         unsigned int MI2C1IP0:1;
         unsigned int MI2C1IP1:1;
         unsigned int MI2C1IP2:1;
         unsigned int :1;
         unsigned int CMIP0:1;
         unsigned int CMIP1:1;
         unsigned int CMIP2:1;
         unsigned int :1;
         unsigned int CNIP0:1;
         unsigned int CNIP1:1;
         unsigned int CNIP2:1;
      };
   };
      struct {
         unsigned int SI2C1IP:3;
         unsigned int :1;
         unsigned int MI2C1IP:3;
         unsigned int :1;
         unsigned int CMIP:3;
         unsigned int :1;
         unsigned int CNIP:3;
      };

      struct {
         unsigned int SI2C1P0:1;
         unsigned int SI2C1P1:1;
         unsigned int SI2C1P2:1;
         unsigned int :1;
         unsigned int MI2C1P0:1;
         unsigned int MI2C1P1:1;
         unsigned int MI2C1P2:1;
      };
   };
      struct {
         unsigned int SI2C1P:3;
         unsigned int :1;
         unsigned int MI2C1P:3;
      };
} IPC4;
#word IPC4 = 0x0AC

union  {
      struct {
         unsigned int INT1IP0:1;
         unsigned int INT1IP1:1;
         unsigned int INT1IP2:1;
         unsigned int :5;
         unsigned int IC7IP0:1;
         unsigned int IC7IP1:1;
         unsigned int IC7IP2:1;
         unsigned int :1;
         unsigned int IC8IP0:1;
         unsigned int IC8IP1:1;
         unsigned int IC8IP2:1;
      };
      struct {
         unsigned int INT1IP:3;
         unsigned int :5;
         unsigned int IC7IP:3;
         unsigned int :1;
         unsigned int IC8IP:3;
      };
} IPC5;
#word IPC5 = 0x0AE

union  {
      struct {
         unsigned int :4;
         unsigned int OC3IP0:1;
         unsigned int OC3IP1:1;
         unsigned int OC3IP2:1;
         unsigned int :1;
         unsigned int OC4IP0:1;
         unsigned int OC4IP1:1;
         unsigned int OC4IP2:1;
         unsigned int :1;
         unsigned int T4IP0:1;
         unsigned int T4IP1:1;
         unsigned int T4IP2:1;
      };
      struct {
         unsigned int :4;
         unsigned int OC3IP:3;
         unsigned int :1;
         unsigned int OC4IP:3;
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
         unsigned int :1;
         unsigned int :6;
         unsigned int :1;
         unsigned int :1;
         unsigned int :1;
      };
} T3CON;
#word T3CON = 0x112

#word TMR4 = 0x114

#word TMR5HLD = 0x116

#word TMR5 = 0x118

#word PR4 = 0x11A

#word PR5 = 0x11C

union  {
      struct {
         unsigned int :1;
         unsigned int TCS:1;
         unsigned int :1;
         unsigned int T3:1;
         unsigned int TCKPS0:1;
         unsigned int TCKPS1:1;
         unsigned int TGATE:1;
         unsigned int :6;
         unsigned int TSIDL:1;
         unsigned int :1;
         unsigned int TON:1;
      };
      struct {
         unsigned int :1;
         unsigned int :1;
         unsigned int :1;
         unsigned int :1;
         unsigned int TCKPS:2;
         unsigned int :1;
         unsigned int :6;
         unsigned int :1;
         unsigned int :1;
         unsigned int :1;
      };
} T4CON;
#word T4CON = 0x11E

union  {
      struct {
         unsigned int :1;
         unsigned int TCS:1;
         unsigned int :2;
         unsigned int TCKPS0:1;
         unsigned int TCKPS1:1;
         unsigned int TGATE:1;
         unsigned int :6;
         unsigned int TSIDL:1;
         unsigned int :1;
         unsigned int TON:1;
      };
      struct {
         unsigned int :1;
         unsigned int :1;
         unsigned int :2;
         unsigned int TCKPS:2;
         unsigned int :1;
         unsigned int :6;
         unsigned int :1;
         unsigned int :1;
         unsigned int :1;
      };
} T5CON;
#word T5CON = 0x120

union  {
      struct {
         unsigned int ICM0:1;
         unsigned int ICM1:1;
         unsigned int ICM2:1;
         unsigned int ICBNE:1;
         unsigned int ICOV:1;
         unsigned int ICI0:1;
         unsigned int ICI1:1;
         unsigned int :3;
         unsigned int ICTSEL0:1;
         unsigned int ICTSEL1:1;
         unsigned int ICTSEL2:1;
         unsigned int ICSIDL:1;
      };
      struct {
         unsigned int ICM:3;
         unsigned int :1;
         unsigned int :1;
         unsigned int ICI:2;
         unsigned int :3;
         unsigned int ICTSEL:3;
         unsigned int :1;
      };
} IC1CON1;
#word IC1CON1 = 0x140

union  {
      struct {
         unsigned int SYNCSEL0:1;
         unsigned int SYNCSEL1:1;
         unsigned int SYNCSEL2:1;
         unsigned int SYNCSEL3:1;
         unsigned int SYNCSEL4:1;
         unsigned int :1;
         unsigned int TRIGSTAT:1;
         unsigned int ICTRIG:1;
         unsigned int IC32:1;
      };
      struct {
         unsigned int SYNCSEL:5;
         unsigned int :1;
         unsigned int :1;
         unsigned int :1;
         unsigned int :1;
      };
} IC1CON2;
#word IC1CON2 = 0x142

#word IC1BUF = 0x144

#word IC1TMR = 0x146

union  {
      struct {
         unsigned int ICM0:1;
         unsigned int ICM1:1;
         unsigned int ICM2:1;
         unsigned int ICBNE:1;
         unsigned int ICOV:1;
         unsigned int ICI0:1;
         unsigned int ICI1:1;
         unsigned int :3;
         unsigned int ICTSEL0:1;
         unsigned int ICTSEL1:1;
         unsigned int ICTSEL2:1;
         unsigned int ICSIDL:1;
      };
      struct {
         unsigned int ICM:3;
         unsigned int :1;
         unsigned int :1;
         unsigned int ICI:2;
         unsigned int :3;
         unsigned int ICTSEL:3;
         unsigned int :1;
      };
} IC2CON1;
#word IC2CON1 = 0x148

union  {
      struct {
         unsigned int SYNCSEL0:1;
         unsigned int SYNCSEL1:1;
         unsigned int SYNCSEL2:1;
         unsigned int SYNCSEL3:1;
         unsigned int SYNCSEL4:1;
         unsigned int :1;
         unsigned int TRIGSTAT:1;
         unsigned int ICTRIG:1;
         unsigned int IC32:1;
      };
      struct {
         unsigned int SYNCSEL:5;
         unsigned int :1;
         unsigned int :1;
         unsigned int :1;
         unsigned int :1;
      };
} IC2CON2;
#word IC2CON2 = 0x14A

#word IC2BUF = 0x14C

#word IC2TMR = 0x14E

union  {
      struct {
         unsigned int ICM0:1;
         unsigned int ICM1:1;
         unsigned int ICM2:1;
         unsigned int ICBNE:1;
         unsigned int ICOV:1;
         unsigned int ICI0:1;
         unsigned int ICI1:1;
         unsigned int :3;
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
         unsigned int IC32:1;
      };
      struct {
         unsigned int SYNCSEL:5;
         unsigned int :1;
         unsigned int :1;
         unsigned int :1;
         unsigned int :1;
      };
} IC9CON2;
#word IC9CON2 = 0x182

#word IC9BUF = 0x184

#word IC9TMR = 0x186

union  {
   union {
      struct {
         unsigned int OCM0:1;
         unsigned int OCM1:1;
         unsigned int OCM2:1;
         unsigned int TRIGMODE:1;
         unsigned int OCFLT0:1;
         unsigned int :2;
         unsigned int ENFLT0:1;
         unsigned int :2;
         unsigned int OCTSEL0:1;
         unsigned int OCTSEL1:1;
         unsigned int OCTSEL2:1;
         unsigned int OCSIDL:1;
      };
      struct {
         unsigned int OCM:3;
         unsigned int :1;
         unsigned int :1;
         unsigned int :2;
         unsigned int :1;
         unsigned int :2;
         unsigned int OCTSEL:3;
         unsigned int :1;
      };

      struct {
         unsigned int OCM0:1;
         unsigned int OCM1:1;
         unsigned int OCM2:1;
         unsigned int :1;
         unsigned int OCFLT:1;
         unsigned int :2;
         unsigned int ENFLT:1;
         unsigned int :2;
         unsigned int OCTSEL0:1;
         unsigned int OCTSEL1:1;
         unsigned int OCTSEL2:1;
      };
   };
      struct {
         unsigned int OCM:3;
         unsigned int :1;
         unsigned int :1;
         unsigned int :2;
         unsigned int :1;
         unsigned int :2;
         unsigned int OCTSEL:3;
      };
} OC1CON1;
#word OC1CON1 = 0x190

union  {
   union {
      struct {
         unsigned int SYNCSEL0:1;
         unsigned int SYNCSEL1:1;
         unsigned int SYNCSEL2:1;
         unsigned int SYNCSEL3:1;
         unsigned int SYNCSEL4:1;
         unsigned int OCTRIS:1;
         unsigned int TRIGSTAT:1;
         unsigned int OCTRIG:1;
         unsigned int OC32:1;
         unsigned int :3;
         unsigned int OCINV:1;
         unsigned int FLTTRIEN:1;
         unsigned int FLTOUT:1;
         unsigned int FLTMD:1;
      };
      struct {
         unsigned int SYNCSEL:5;
         unsigned int :1;
         unsigned int :1;
         unsigned int :1;
         unsigned int :1;
         unsigned int :3;
         unsigned int :1;
         unsigned int :1;
         unsigned int :1;
         unsigned int :1;
      };

      struct {
         unsigned int SYNCSEL0:1;
         unsigned int SYNCSEL1:1;
         unsigned int SYNCSEL2:1;
         unsigned int SYNCSEL3:1;
         unsigned int SYNCSEL4:1;
         unsigned int :10;
         unsigned int FLTMODE:1;
      };
   };
      struct {
         unsigned int SYNCSEL:5;
         unsigned int :10;
         unsigned int :1;
      };
} OC1CON2;
#word OC1CON2 = 0x192

#word OC1RS = 0x194

#word OC1R = 0x196

#word OC1TMR = 0x198

union  {
   union {
      struct {
         unsigned int OCM0:1;
         unsigned int OCM1:1;
         unsigned int OCM2:1;
         unsigned int TRIGMODE:1;
         unsigned int OCFLT0:1;
         unsigned int :2;
         unsigned int ENFLT0:1;
         unsigned int :2;
         unsigned int OCTSEL0:1;
         unsigned int OCTSEL1:1;
         unsigned int OCTSEL2:1;
         unsigned int OCSIDL:1;
      };
      struct {
         unsigned int OCM:3;
         unsigned int :1;
         unsigned int :1;
         unsigned int :2;
         unsigned int :1;
         unsigned int :2;
         unsigned int OCTSEL:3;
         unsigned int :1;
      };

      struct {
         unsigned int OCM0:1;
         unsigned int OCM1:1;
         unsigned int OCM2:1;
         unsigned int :1;
         unsigned int OCFLT:1;
         unsigned int :2;
         unsigned int ENFLT:1;
         unsigned int :2;
         unsigned int OCTSEL0:1;
         unsigned int OCTSEL1:1;
         unsigned int OCTSEL2:1;
      };
   };
      struct {
         unsigned int OCM:3;
         unsigned int :1;
         unsigned int :1;
         unsigned int :2;
         unsigned int :1;
         unsigned int :2;
         unsigned int OCTSEL:3;
      };
} OC2CON1;
#word OC2CON1 = 0x19A

union  {
   union {
      struct {
         unsigned int SYNCSEL0:1;
         unsigned int SYNCSEL1:1;
         unsigned int SYNCSEL2:1;
         unsigned int SYNCSEL3:1;
         unsigned int SYNCSEL4:1;
         unsigned int OCTRIS:1;
         unsigned int TRIGSTAT:1;
         unsigned int OCTRIG:1;
         unsigned int OC32:1;
         unsigned int :3;
         unsigned int OCINV:1;
         unsigned int FLTTRIEN:1;
         unsigned int FLTOUT:1;
         unsigned int FLTMD:1;
      };
      struct {
         unsigned int SYNCSEL:5;
         unsigned int :1;
         unsigned int :1;
         unsigned int :1;
         unsigned int :1;
         unsigned int :3;
         unsigned int :1;
         unsigned int :1;
         unsigned int :1;
         unsigned int :1;
      };

      struct {
         unsigned int SYNCSEL0:1;
         unsigned int SYNCSEL1:1;
         unsigned int SYNCSEL2:1;
         unsigned int SYNCSEL3:1;
         unsigned int SYNCSEL4:1;
         unsigned int :10;
         unsigned int FLTMODE:1;
      };
   };
      struct {
         unsigned int SYNCSEL:5;
         unsigned int :10;
         unsigned int :1;
      };
} OC2CON2;
#word OC2CON2 = 0x19C

#word OC2RS = 0x19E

#word OC2R = 0x1A0

#word OC2TMR = 0x1A2

union  {
   union {
      struct {
         unsigned int OCM0:1;
         unsigned int OCM1:1;
         unsigned int OCM2:1;
         unsigned int TRIGMODE:1;
         unsigned int OCFLT0:1;
         unsigned int :2;
         unsigned int ENFLT0:1;
         unsigned int :2;
         unsigned int OCTSEL0:1;
         unsigned int OCTSEL1:1;
         unsigned int OCTSEL2:1;
         unsigned int OCSIDL:1;
      };
      struct {
         unsigned int OCM:3;
         unsigned int :1;
         unsigned int :1;
         unsigned int :2;
         unsigned int :1;
         unsigned int :2;
         unsigned int OCTSEL:3;
         unsigned int :1;
      };

      struct {
         unsigned int OCM0:1;
         unsigned int OCM1:1;
         unsigned int OCM2:1;
         unsigned int :1;
         unsigned int OCFLT:1;
         unsigned int :2;
         unsigned int ENFLT:1;
         unsigned int :2;
         unsigned int OCTSEL0:1;
         unsigned int OCTSEL1:1;
         unsigned int OCTSEL2:1;
      };
   };
      struct {
         unsigned int OCM:3;
         unsigned int :1;
         unsigned int :1;
         unsigned int :2;
         unsigned int :1;
         unsigned int :2;
         unsigned int OCTSEL:3;
      };
} OC3CON1;
#word OC3CON1 = 0x1A4

union  {
   union {
      struct {
         unsigned int SYNCSEL0:1;
         unsigned int SYNCSEL1:1;
         unsigned int SYNCSEL2:1;
         unsigned int SYNCSEL3:1;
         unsigned int SYNCSEL4:1;
         unsigned int OCTRIS:1;
         unsigned int TRIGSTAT:1;
         unsigned int OCTRIG:1;
         unsigned int OC32:1;
         unsigned int :3;
         unsigned int OCINV:1;
         unsigned int FLTTRIEN:1;
         unsigned int FLTOUT:1;
         unsigned int FLTMD:1;
      };
      struct {
         unsigned int SYNCSEL:5;
         unsigned int :1;
         unsigned int :1;
         unsigned int :1;
         unsigned int :1;
         unsigned int :3;
         unsigned int :1;
         unsigned int :1;
         unsigned int :1;
         unsigned int :1;
      };

      struct {
         unsigned int SYNCSEL0:1;
         unsigned int SYNCSEL1:1;
         unsigned int SYNCSEL2:1;
         unsigned int SYNCSEL3:1;
         unsigned int SYNCSEL4:1;
         unsigned int :10;
         unsigned int FLTMODE:1;
      };
   };
      struct {
         unsigned int SYNCSEL:5;
         unsigned int :10;
         unsigned int :1;
      };
} OC3CON2;
#word OC3CON2 = 0x1A6

#word OC3RS = 0x1A8

#word OC3R = 0x1AA

#word OC3TMR = 0x1AC

union  {
   union {
      struct {
         unsigned int OCM0:1;
         unsigned int OCM1:1;
         unsigned int OCM2:1;
         unsigned int TRIGMODE:1;
         unsigned int OCFLT0:1;
         unsigned int :2;
         unsigned int ENFLT0:1;
         unsigned int :2;
         unsigned int OCTSEL0:1;
         unsigned int OCTSEL1:1;
         unsigned int OCTSEL2:1;
         unsigned int OCSIDL:1;
      };
      struct {
         unsigned int OCM:3;
         unsigned int :1;
         unsigned int :1;
         unsigned int :2;
         unsigned int :1;
         unsigned int :2;
         unsigned int OCTSEL:3;
         unsigned int :1;
      };

      struct {
         unsigned int OCM0:1;
         unsigned int OCM1:1;
         unsigned int OCM2:1;
         unsigned int :1;
         unsigned int OCFLT:1;
         unsigned int :2;
         unsigned int ENFLT:1;
         unsigned int :2;
         unsigned int OCTSEL0:1;
         unsigned int OCTSEL1:1;
         unsigned int OCTSEL2:1;
      };
   };
      struct {
         unsigned int OCM:3;
         unsigned int :1;
         unsigned int :1;
         unsigned int :2;
         unsigned int :1;
         unsigned int :2;
         unsigned int OCTSEL:3;
      };
} OC4CON1;
#word OC4CON1 = 0x1AE

union  {
   union {
      struct {
         unsigned int SYNCSEL0:1;
         unsigned int SYNCSEL1:1;
         unsigned int SYNCSEL2:1;
         unsigned int SYNCSEL3:1;
         unsigned int SYNCSEL4:1;
         unsigned int OCTRIS:1;
         unsigned int TRIGSTAT:1;
         unsigned int OCTRIG:1;
         unsigned int OC32:1;
         unsigned int :3;
         unsigned int OCINV:1;
         unsigned int FLTTRIEN:1;
         unsigned int FLTOUT:1;
         unsigned int FLTMD:1;
      };
      struct {
         unsigned int SYNCSEL:5;
         unsigned int :1;
         unsigned int :1;
         unsigned int :1;
         unsigned int :1;
         unsigned int :3;
         unsigned int :1;
         unsigned int :1;
         unsigned int :1;
         unsigned int :1;
      };

      struct {
         unsigned int SYNCSEL0:1;
         unsigned int SYNCSEL1:1;
         unsigned int SYNCSEL2:1;
         unsigned int SYNCSEL3:1;
         unsigned int SYNCSEL4:1;
         unsigned int :10;
         unsigned int FLTMODE:1;
      };
   };
      struct {
         unsigned int SYNCSEL:5;
         unsigned int :10;
         unsigned int :1;
      };
} OC4CON2;
#word OC4CON2 = 0x1B0

#word OC4RS = 0x1B2

#word OC4R = 0x1B4

#word OC4TMR = 0x1B6

union  {
   union {
      struct {
         unsigned int OCM0:1;
         unsigned int OCM1:1;
         unsigned int OCM2:1;
         unsigned int TRIGMODE:1;
         unsigned int OCFLT0:1;
         unsigned int :2;
         unsigned int ENFLT0:1;
         unsigned int :2;
         unsigned int OCTSEL0:1;
         unsigned int OCTSEL1:1;
         unsigned int OCTSEL2:1;
         unsigned int OCSIDL:1;
      };
      struct {
         unsigned int OCM:3;
         unsigned int :1;
         unsigned int :1;
         unsigned int :2;
         unsigned int :1;
         unsigned int :2;
         unsigned int OCTSEL:3;
         unsigned int :1;
      };

      struct {
         unsigned int OCM0:1;
         unsigned int OCM1:1;
         unsigned int OCM2:1;
         unsigned int :1;
         unsigned int OCFLT:1;
         unsigned int :2;
         unsigned int ENFLT:1;
         unsigned int :2;
         unsigned int OCTSEL0:1;
         unsigned int OCTSEL1:1;
         unsigned int OCTSEL2:1;
      };
   };
      struct {
         unsigned int OCM:3;
         unsigned int :1;
         unsigned int :1;
         unsigned int :2;
         unsigned int :1;
         unsigned int :2;
         unsigned int OCTSEL:3;
      };
} OC5CON1;
#word OC5CON1 = 0x1B8

union  {
   union {
      struct {
         unsigned int SYNCSEL0:1;
         unsigned int SYNCSEL1:1;
         unsigned int SYNCSEL2:1;
         unsigned int SYNCSEL3:1;
         unsigned int SYNCSEL4:1;
         unsigned int OCTRIS:1;
         unsigned int TRIGSTAT:1;
         unsigned int OCTRIG:1;
         unsigned int OC32:1;
         unsigned int :3;
         unsigned int OCINV:1;
         unsigned int FLTTRIEN:1;
         unsigned int FLTOUT:1;
         unsigned int FLTMD:1;
      };
      struct {
         unsigned int SYNCSEL:5;
         unsigned int :1;
         unsigned int :1;
         unsigned int :1;
         unsigned int :1;
         unsigned int :3;
         unsigned int :1;
         unsigned int :1;
         unsigned int :1;
         unsigned int :1;
      };

      struct {
         unsigned int SYNCSEL0:1;
         unsigned int SYNCSEL1:1;
         unsigned int SYNCSEL2:1;
         unsigned int SYNCSEL3:1;
         unsigned int SYNCSEL4:1;
         unsigned int :10;
         unsigned int FLTMODE:1;
      };
   };
      struct {
         unsigned int SYNCSEL:5;
         unsigned int :10;
         unsigned int :1;
      };
} OC5CON2;
#word OC5CON2 = 0x1BA

#word OC5RS = 0x1BC

#word OC5R = 0x1BE

#word OC5TMR = 0x1C0

union  {
   union {
      struct {
         unsigned int OCM0:1;
         unsigned int OCM1:1;
         unsigned int OCM2:1;
         unsigned int TRIGMODE:1;
         unsigned int OCFLT0:1;
         unsigned int :2;
         unsigned int ENFLT0:1;
         unsigned int :2;
         unsigned int OCTSEL0:1;
         unsigned int OCTSEL1:1;
         unsigned int OCTSEL2:1;
         unsigned int OCSIDL:1;
      };
      struct {
         unsigned int OCM:3;
         unsigned int :1;
         unsigned int :1;
         unsigned int :2;
         unsigned int :1;
         unsigned int :2;
         unsigned int OCTSEL:3;
         unsigned int :1;
      };

      struct {
         unsigned int OCM0:1;
         unsigned int OCM1:1;
         unsigned int OCM2:1;
         unsigned int :1;
         unsigned int OCFLT:1;
         unsigned int :2;
         unsigned int ENFLT:1;
         unsigned int :2;
         unsigned int OCTSEL0:1;
         unsigned int OCTSEL1:1;
         unsigned int OCTSEL2:1;
      };
   };
      struct {
         unsigned int OCM:3;
         unsigned int :1;
         unsigned int :1;
         unsigned int :2;
         unsigned int :1;
         unsigned int :2;
         unsigned int OCTSEL:3;
      };
} OC6CON1;
#word OC6CON1 = 0x1C2

union  {
   union {
      struct {
         unsigned int SYNCSEL0:1;
         unsigned int SYNCSEL1:1;
         unsigned int SYNCSEL2:1;
         unsigned int SYNCSEL3:1;
         unsigned int SYNCSEL4:1;
         unsigned int OCTRIS:1;
         unsigned int TRIGSTAT:1;
         unsigned int OCTRIG:1;
         unsigned int OC32:1;
         unsigned int :3;
         unsigned int OCINV:1;
         unsigned int FLTTRIEN:1;
         unsigned int FLTOUT:1;
         unsigned int FLTMD:1;
      };
      struct {
         unsigned int SYNCSEL:5;
         unsigned int :1;
         unsigned int :1;
         unsigned int :1;
         unsigned int :1;
         unsigned int :3;
         unsigned int :1;
         unsigned int :1;
         unsigned int :1;
         unsigned int :1;
      };

      struct {
         unsigned int SYNCSEL0:1;
         unsigned int SYNCSEL1:1;
         unsigned int SYNCSEL2:1;
         unsigned int SYNCSEL3:1;
         unsigned int SYNCSEL4:1;
         unsigned int :10;
         unsigned int FLTMODE:1;
      };
   };
      struct {
         unsigned int SYNCSEL:5;
         unsigned int :10;
         unsigned int :1;
      };
} OC6CON2;
#word OC6CON2 = 0x1C4

#word OC6RS = 0x1C6

#word OC6R = 0x1C8

#word OC6TMR = 0x1CA

union  {
   union {
      struct {
         unsigned int OCM0:1;
         unsigned int OCM1:1;
         unsigned int OCM2:1;
         unsigned int TRIGMODE:1;
         unsigned int OCFLT0:1;
         unsigned int :2;
         unsigned int ENFLT0:1;
         unsigned int :2;
         unsigned int OCTSEL0:1;
         unsigned int OCTSEL1:1;
         unsigned int OCTSEL2:1;
         unsigned int OCSIDL:1;
      };
      struct {
         unsigned int OCM:3;
         unsigned int :1;
         unsigned int :1;
         unsigned int :2;
         unsigned int :1;
         unsigned int :2;
         unsigned int OCTSEL:3;
         unsigned int :1;
      };

      struct {
         unsigned int OCM0:1;
         unsigned int OCM1:1;
         unsigned int OCM2:1;
         unsigned int :1;
         unsigned int OCFLT:1;
         unsigned int :2;
         unsigned int ENFLT:1;
         unsigned int :2;
         unsigned int OCTSEL0:1;
         unsigned int OCTSEL1:1;
         unsigned int OCTSEL2:1;
      };
   };
      struct {
         unsigned int OCM:3;
         unsigned int :1;
         unsigned int :1;
         unsigned int :2;
         unsigned int :1;
         unsigned int :2;
         unsigned int OCTSEL:3;
      };
} OC7CON1;
#word OC7CON1 = 0x1CC

union  {
   union {
      struct {
         unsigned int SYNCSEL0:1;
         unsigned int SYNCSEL1:1;
         unsigned int SYNCSEL2:1;
         unsigned int SYNCSEL3:1;
         unsigned int SYNCSEL4:1;
         unsigned int OCTRIS:1;
         unsigned int TRIGSTAT:1;
         unsigned int OCTRIG:1;
         unsigned int OC32:1;
         unsigned int :3;
         unsigned int OCINV:1;
         unsigned int FLTTRIEN:1;
         unsigned int FLTOUT:1;
         unsigned int FLTMD:1;
      };
      struct {
         unsigned int SYNCSEL:5;
         unsigned int :1;
         unsigned int :1;
         unsigned int :1;
         unsigned int :1;
         unsigned int :3;
         unsigned int :1;
         unsigned int :1;
         unsigned int :1;
         unsigned int :1;
      };

      struct {
         unsigned int SYNCSEL0:1;
         unsigned int SYNCSEL1:1;
         unsigned int SYNCSEL2:1;
         unsigned int SYNCSEL3:1;
         unsigned int SYNCSEL4:1;
         unsigned int :10;
         unsigned int FLTMODE:1;
      };
   };
      struct {
         unsigned int SYNCSEL:5;
         unsigned int :10;
         unsigned int :1;
      };
} OC7CON2;
#word OC7CON2 = 0x1CE

#word OC7RS = 0x1D0

#word OC7R = 0x1D2

#word OC7TMR = 0x1D4

union  {
   union {
      struct {
         unsigned int OCM0:1;
         unsigned int OCM1:1;
         unsigned int OCM2:1;
         unsigned int TRIGMODE:1;
         unsigned int OCFLT0:1;
         unsigned int :2;
         unsigned int ENFLT0:1;
         unsigned int :2;
         unsigned int OCTSEL0:1;
         unsigned int OCTSEL1:1;
         unsigned int OCTSEL2:1;
         unsigned int OCSIDL:1;
      };
      struct {
         unsigned int OCM:3;
         unsigned int :1;
         unsigned int :1;
         unsigned int :2;
         unsigned int :1;
         unsigned int :2;
         unsigned int OCTSEL:3;
         unsigned int :1;
      };

      struct {
         unsigned int OCM0:1;
         unsigned int OCM1:1;
         unsigned int OCM2:1;
         unsigned int :1;
         unsigned int OCFLT:1;
         unsigned int :2;
         unsigned int ENFLT:1;
         unsigned int :2;
         unsigned int OCTSEL0:1;
         unsigned int OCTSEL1:1;
         unsigned int OCTSEL2:1;
      };
   };
      struct {
         unsigned int OCM:3;
         unsigned int :1;
         unsigned int :1;
         unsigned int :2;
         unsigned int :1;
         unsigned int :2;
         unsigned int OCTSEL:3;
      };
} OC8CON1;
#word OC8CON1 = 0x1D6

union  {
   union {
      struct {
         unsigned int SYNCSEL0:1;
         unsigned int SYNCSEL1:1;
         unsigned int SYNCSEL2:1;
         unsigned int SYNCSEL3:1;
         unsigned int SYNCSEL4:1;
         unsigned int OCTRIS:1;
         unsigned int TRIGSTAT:1;
         unsigned int OCTRIG:1;
         unsigned int OC32:1;
         unsigned int :3;
         unsigned int OCINV:1;
         unsigned int FLTTRIEN:1;
         unsigned int FLTOUT:1;
         unsigned int FLTMD:1;
      };
      struct {
         unsigned int SYNCSEL:5;
         unsigned int :1;
         unsigned int :1;
         unsigned int :1;
         unsigned int :1;
         unsigned int :3;
         unsigned int :1;
         unsigned int :1;
         unsigned int :1;
         unsigned int :1;
      };

      struct {
         unsigned int SYNCSEL0:1;
         unsigned int SYNCSEL1:1;
         unsigned int SYNCSEL2:1;
         unsigned int SYNCSEL3:1;
         unsigned int SYNCSEL4:1;
         unsigned int :10;
         unsigned int FLTMODE:1;
      };
   };
      struct {
         unsigned int SYNCSEL:5;
         unsigned int :10;
         unsigned int :1;
      };
} OC8CON2;
#word OC8CON2 = 0x1D8

#word OC8RS = 0x1DA

#word OC8R = 0x1DC

#word OC8TMR = 0x1DE

union  {
   union {
      struct {
         unsigned int OCM0:1;
         unsigned int OCM1:1;
         unsigned int OCM2:1;
         unsigned int TRIGMODE:1;
         unsigned int OCFLT0:1;
         unsigned int :2;
         unsigned int ENFLT0:1;
         unsigned int :2;
         unsigned int OCTSEL0:1;
         unsigned int OCTSEL1:1;
         unsigned int OCTSEL2:1;
         unsigned int OCSIDL:1;
      };
      struct {
         unsigned int OCM:3;
         unsigned int :1;
         unsigned int :1;
         unsigned int :2;
         unsigned int :1;
         unsigned int :2;
         unsigned int OCTSEL:3;
         unsigned int :1;
      };

      struct {
         unsigned int OCM0:1;
         unsigned int OCM1:1;
         unsigned int OCM2:1;
         unsigned int :1;
         unsigned int OCFLT:1;
         unsigned int :2;
         unsigned int ENFLT:1;
         unsigned int :2;
         unsigned int OCTSEL0:1;
         unsigned int OCTSEL1:1;
         unsigned int OCTSEL2:1;
      };
   };
      struct {
         unsigned int OCM:3;
         unsigned int :1;
         unsigned int :1;
         unsigned int :2;
         unsigned int :1;
         unsigned int :2;
         unsigned int OCTSEL:3;
      };
} OC9CON1;
#word OC9CON1 = 0x1E0

union  {
   union {
      struct {
         unsigned int SYNCSEL0:1;
         unsigned int SYNCSEL1:1;
         unsigned int SYNCSEL2:1;
         unsigned int SYNCSEL3:1;
         unsigned int SYNCSEL4:1;
         unsigned int OCTRIS:1;
         unsigned int TRIGSTAT:1;
         unsigned int OCTRIG:1;
         unsigned int OC32:1;
         unsigned int :3;
         unsigned int OCINV:1;
         unsigned int FLTTRIEN:1;
         unsigned int FLTOUT:1;
         unsigned int FLTMD:1;
      };
      struct {
         unsigned int SYNCSEL:5;
         unsigned int :1;
         unsigned int :1;
         unsigned int :1;
         unsigned int :1;
         unsigned int :3;
         unsigned int :1;
         unsigned int :1;
         unsigned int :1;
         unsigned int :1;
      };

      struct {
         unsigned int SYNCSEL0:1;
         unsigned int SYNCSEL1:1;
         unsigned int SYNCSEL2:1;
         unsigned int SYNCSEL3:1;
         unsigned int SYNCSEL4:1;
         unsigned int :10;
         unsigned int FLTMODE:1;
      };
   };
      struct {
         unsigned int SYNCSEL:5;
         unsigned int :10;
         unsigned int :1;
      };
} OC9CON2;
#word OC9CON2 = 0x1E2

#word OC9RS = 0x1E4

#word OC9R = 0x1E6

#word OC9TMR = 0x1E8

#word I2C1RCV = 0x200

#word I2C1TRN = 0x202

#word I2C1BRG = 0x204

struct  {
   unsigned int SEN:1;
   unsigned int RSEN:1;
   unsigned int PEN:1;
   unsigned int RCEN:1;
   unsigned int ACKEN:1;
   unsigned int ACKDT:1;
   unsigned int STREN:1;
   unsigned int GCEN:1;
   unsigned int SMEN:1;
   unsigned int DISSLW:1;
   unsigned int A10M:1;
   unsigned int IPMIEN:1;
   unsigned int SCLREL:1;
   unsigned int I2CSIDL:1;
   unsigned int :1;
   unsigned int I2CEN:1;
} I2C1CON;
#word I2C1CON = 0x206

struct  {
   union {
      struct {
         unsigned int TBF:1;
         unsigned int RBF:1;
         unsigned int R:1;
         unsigned int S:1;
         unsigned int P:1;
         unsigned int D:1;
         unsigned int I2COV:1;
         unsigned int IWCOL:1;
         unsigned int ADD:1;
         unsigned int GCSTAT:1;
         unsigned int BCL:1;
         unsigned int :3;
         unsigned int TRSTAT:1;
         unsigned int ACKSTAT:1;
      };

   union {
      struct {
         unsigned int :2;
         unsigned int R_W:1;
         unsigned int :2;
         unsigned int D_A:1;
      };
   };

      struct {
         unsigned int TBF:1;
         unsigned int RBF:1;
         unsigned int R:1;
         unsigned int S:1;
         unsigned int P:1;
         unsigned int D:1;
         unsigned int I2COV:1;
         unsigned int IWCOL:1;
         unsigned int ADD:1;
         unsigned int GCSTAT:1;
         unsigned int BCL:1;
         unsigned int :3;
         unsigned int TRSTAT:1;
         unsigned int ACKSTAT:1;
      };
   };
} I2C1STAT;
#word I2C1STAT = 0x208

#word I2C1ADD = 0x20A

#word I2C1MSK = 0x20C

#word I2C2RCV = 0x210

#word I2C2TRN = 0x212

#word I2C2BRG = 0x214

struct  {
   unsigned int SEN:1;
   unsigned int RSEN:1;
   unsigned int PEN:1;
   unsigned int RCEN:1;
   unsigned int ACKEN:1;
   unsigned int ACKDT:1;
   unsigned int STREN:1;
   unsigned int GCEN:1;
   unsigned int SMEN:1;
   unsigned int DISSLW:1;
   unsigned int A10M:1;
   unsigned int IPMIEN:1;
   unsigned int SCLREL:1;
   unsigned int I2CSIDL:1;
   unsigned int :1;
   unsigned int I2CEN:1;
} I2C2CON;
#word I2C2CON = 0x216

struct  {
   union {
      struct {
         unsigned int TBF:1;
         unsigned int RBF:1;
         unsigned int R:1;
         unsigned int S:1;
         unsigned int P:1;
         unsigned int D:1;
         unsigned int I2COV:1;
         unsigned int IWCOL:1;
         unsigned int ADD:1;
         unsigned int GCSTAT:1;
         unsigned int BCL:1;
         unsigned int :3;
         unsigned int TRSTAT:1;
         unsigned int ACKSTAT:1;
      };

   union {
      struct {
         unsigned int :2;
         unsigned int R_W:1;
         unsigned int :2;
         unsigned int D_A:1;
      };
   };

      struct {
         unsigned int TBF:1;
         unsigned int RBF:1;
         unsigned int R:1;
         unsigned int S:1;
         unsigned int P:1;
         unsigned int D:1;
         unsigned int I2COV:1;
         unsigned int IWCOL:1;
         unsigned int ADD:1;
         unsigned int GCSTAT:1;
         unsigned int BCL:1;
         unsigned int :3;
         unsigned int TRSTAT:1;
         unsigned int ACKSTAT:1;
      };
   };
} I2C2STAT;
#word I2C2STAT = 0x218

#word I2C2ADD = 0x21A

#word I2C2MSK = 0x21C

union  {
      struct {
         unsigned int STSEL:1;
         unsigned int PDSEL0:1;
         unsigned int PDSEL1:1;
         unsigned int BRGH:1;
         unsigned int RXINV:1;
         unsigned int ABAUD:1;
         unsigned int LPBACK:1;
         unsigned int WAKE:1;
         unsigned int UEN0:1;
         unsigned int UEN1:1;
         unsigned int :1;
         unsigned int RTSMD:1;
         unsigned int IREN:1;
         unsigned int USIDL:1;
         unsigned int :1;
         unsigned int UARTEN:1;
      };
      struct {
         unsigned int :1;
         unsigned int PDSEL:2;
         unsigned int :1;
         unsigned int :1;
         unsigned int :1;
         unsigned int :1;
         unsigned int :1;
         unsigned int UEN:2;
         unsigned int :1;
         unsigned int :1;
         unsigned int :1;
         unsigned int :1;
         unsigned int :1;
         unsigned int :1;
      };
} U1MODE;
#word U1MODE = 0x220

union  {
      struct {
         unsigned int URXDA:1;
         unsigned int OERR:1;
         unsigned int FERR:1;
         unsigned int PERR:1;
         unsigned int RIDLE:1;
         unsigned int ADDEN:1;
         unsigned int URXISEL0:1;
         unsigned int URXISEL1:1;
         unsigned int TRMT:1;
         unsigned int UTXBF:1;
         unsigned int UTXEN:1;
         unsigned int UTXBRK:1;
         unsigned int :1;
         unsigned int UTXISEL0:1;
         unsigned int UTXINV:1;
         unsigned int UTXISEL1:1;
      };
      struct {
         unsigned int :1;
         unsigned int :1;
         unsigned int :1;
         unsigned int :1;
         unsigned int :1;
         unsigned int :1;
         unsigned int URXISEL:2;
         unsigned int :1;
         unsigned int :1;
         unsigned int :1;
         unsigned int :1;
         unsigned int :1;
         unsigned int UTXISEL:1;
         unsigned int :1;
         unsigned int :1;
      };
} U1STA;
#word U1STA = 0x222

union  {
      struct {
         unsigned int UTXREG0:1;
         unsigned int UTXREG1:1;
         unsigned int UTXREG2:1;
         unsigned int UTXREG3:1;
         unsigned int UTXREG4:1;
         unsigned int UTXREG5:1;
         unsigned int UTXREG6:1;
         unsigned int UTXREG7:1;
         unsigned int UTXREG8:1;
      };
      struct {
         unsigned int UTXREG:9;
      };
} U1TXREG;
#word U1TXREG = 0x224

union  {
      struct {
         unsigned int URXREG0:1;
         unsigned int URXREG1:1;
         unsigned int URXREG2:1;
         unsigned int URXREG3:1;
         unsigned int URXREG4:1;
         unsigned int URXREG5:1;
         unsigned int URXREG6:1;
         unsigned int URXREG7:1;
         unsigned int URXREG8:1;
      };
      struct {
         unsigned int URXREG:9;
      };
} U1RXREG;
#word U1RXREG = 0x226

#word U1BRG = 0x228

union  {
      struct {
         unsigned int STSEL:1;
         unsigned int PDSEL0:1;
         unsigned int PDSEL1:1;
         unsigned int BRGH:1;
         unsigned int RXINV:1;
         unsigned int ABAUD:1;
         unsigned int LPBACK:1;
         unsigned int WAKE:1;
         unsigned int UEN0:1;
         unsigned int UEN1:1;
         unsigned int :1;
         unsigned int RTSMD:1;
         unsigned int IREN:1;
         unsigned int USIDL:1;
         unsigned int :1;
         unsigned int UARTEN:1;
      };
      struct {
         unsigned int :1;
         unsigned int PDSEL:2;
         unsigned int :1;
         unsigned int :1;
         unsigned int :1;
         unsigned int :1;
         unsigned int :1;
         unsigned int UEN:2;
         unsigned int :1;
         unsigned int :1;
         unsigned int :1;
         unsigned int :1;
         unsigned int :1;
         unsigned int :1;
      };
} U2MODE;
#word U2MODE = 0x230

union  {
      struct {
         unsigned int URXDA:1;
         unsigned int OERR:1;
         unsigned int FERR:1;
         unsigned int PERR:1;
         unsigned int RIDLE:1;
         unsigned int ADDEN:1;
         unsigned int URXISEL0:1;
         unsigned int URXISEL1:1;
         unsigned int TRMT:1;
         unsigned int UTXBF:1;
         unsigned int UTXEN:1;
         unsigned int UTXBRK:1;
         unsigned int :1;
         unsigned int UTXISEL0:1;
         unsigned int UTXINV:1;
         unsigned int UTXISEL1:1;
      };
      struct {
         unsigned int :1;
         unsigned int :1;
         unsigned int :1;
         unsigned int :1;
         unsigned int :1;
         unsigned int :1;
         unsigned int URXISEL:2;
         unsigned int :1;
         unsigned int :1;
         unsigned int :1;
         unsigned int :1;
         unsigned int :1;
         unsigned int UTXISEL:1;
         unsigned int :1;
         unsigned int :1;
      };
} U2STA;
#word U2STA = 0x232

union  {
      struct {
         unsigned int UTXREG0:1;
         unsigned int UTXREG1:1;
         unsigned int UTXREG2:1;
         unsigned int UTXREG3:1;
         unsigned int UTXREG4:1;
         unsigned int UTXREG5:1;
         unsigned int UTXREG6:1;
         unsigned int UTXREG7:1;
         unsigned int UTXREG8:1;
      };
      struct {
         unsigned int UTXREG:9;
      };
} U2TXREG;
#word U2TXREG = 0x234

union  {
      struct {
         unsigned int URXREG0:1;
         unsigned int URXREG1:1;
         unsigned int URXREG2:1;
         unsigned int URXREG3:1;
         unsigned int URXREG4:1;
         unsigned int URXREG5:1;
         unsigned int URXREG6:1;
         unsigned int URXREG7:1;
         unsigned int URXREG8:1;
      };
      struct {
         unsigned int URXREG:9;
      };
} U2RXREG;
#word U2RXREG = 0x236

#word U2BRG = 0x238

union  {
      struct {
         unsigned int SPIRBF:1;
         unsigned int SPITBF:1;
         unsigned int SISEL0:1;
         unsigned int SISEL1:1;
         unsigned int SISEL2:1;
         unsigned int SRXMPT:1;
         unsigned int SPIROV:1;
         unsigned int SRMPT:1;
         unsigned int SPIBEC0:1;
         unsigned int SPIBEC1:1;
         unsigned int SPIBEC2:1;
         unsigned int :2;
         unsigned int SPISIDL:1;
         unsigned int :1;
         unsigned int SPIEN:1;
      };
      struct {
         unsigned int :1;
         unsigned int :1;
         unsigned int SISEL:3;
         unsigned int :1;
         unsigned int :1;
         unsigned int :1;
         unsigned int SPIBEC:3;
         unsigned int :2;
         unsigned int :1;
         unsigned int :1;
         unsigned int :1;
      };
} SPI1STAT;
#word SPI1STAT = 0x240

union  {
      struct {
         unsigned int PPRE0:1;
         unsigned int PPRE1:1;
         unsigned int SPRE0:1;
         unsigned int SPRE1:1;
         unsigned int SPRE2:1;
         unsigned int MSTEN:1;
         unsigned int CKP:1;
         unsigned int SSEN:1;
         unsigned int CKE:1;
         unsigned int SMP:1;
         unsigned int MODE:1;
         unsigned int DISSDO:1;
         unsigned int DISSCK:1;
      };
      struct {
         unsigned int PPRE:2;
         unsigned int SPRE:3;
         unsigned int :1;
         unsigned int :1;
         unsigned int :1;
         unsigned int :1;
         unsigned int :1;
         unsigned int :1;
         unsigned int :1;
         unsigned int :1;
      };
} SPI1CON1;
#word SPI1CON1 = 0x242

struct  {
   unsigned int SPIBEN:1;
   unsigned int SPIFE:1;
   unsigned int :11;
   unsigned int SPIFPOL:1;
   unsigned int SPIFSD:1;
   unsigned int FRMEN:1;
} SPI1CON2;
#word SPI1CON2 = 0x244

#word SPI1BUF = 0x248

union  {
      struct {
         unsigned int STSEL:1;
         unsigned int PDSEL0:1;
         unsigned int PDSEL1:1;
         unsigned int BRGH:1;
         unsigned int RXINV:1;
         unsigned int ABAUD:1;
         unsigned int LPBACK:1;
         unsigned int WAKE:1;
         unsigned int UEN0:1;
         unsigned int UEN1:1;
         unsigned int :1;
         unsigned int RTSMD:1;
         unsigned int IREN:1;
         unsigned int USIDL:1;
         unsigned int :1;
         unsigned int UARTEN:1;
      };
      struct {
         unsigned int :1;
         unsigned int PDSEL:2;
         unsigned int :1;
         unsigned int :1;
         unsigned int :1;
         unsigned int :1;
         unsigned int :1;
         unsigned int UEN:2;
         unsigned int :1;
         unsigned int :1;
         unsigned int :1;
         unsigned int :1;
         unsigned int :1;
         unsigned int :1;
      };
} U3MODE;
#word U3MODE = 0x250

union  {
      struct {
         unsigned int URXDA:1;
         unsigned int OERR:1;
         unsigned int FERR:1;
         unsigned int PERR:1;
         unsigned int RIDLE:1;
         unsigned int ADDEN:1;
         unsigned int URXISEL0:1;
         unsigned int URXISEL1:1;
         unsigned int TRMT:1;
         unsigned int UTXBF:1;
         unsigned int UTXEN:1;
         unsigned int UTXBRK:1;
         unsigned int :1;
         unsigned int UTXISEL0:1;
         unsigned int UTXINV:1;
         unsigned int UTXISEL1:1;
      };
      struct {
         unsigned int :1;
         unsigned int :1;
         unsigned int :1;
         unsigned int :1;
         unsigned int :1;
         unsigned int :1;
         unsigned int URXISEL:2;
         unsigned int :1;
         unsigned int :1;
         unsigned int :1;
         unsigned int :1;
         unsigned int :1;
         unsigned int UTXISEL:1;
         unsigned int :1;
         unsigned int :1;
      };
} U3STA;
#word U3STA = 0x252

union  {
      struct {
         unsigned int UTXREG0:1;
         unsigned int UTXREG1:1;
         unsigned int UTXREG2:1;
         unsigned int UTXREG3:1;
         unsigned int UTXREG4:1;
         unsigned int UTXREG5:1;
         unsigned int UTXREG6:1;
         unsigned int UTXREG7:1;
         unsigned int UTXREG8:1;
      };
      struct {
         unsigned int UTXREG:9;
      };
} U3TXREG;
#word U3TXREG = 0x254

union  {
      struct {
         unsigned int URXREG0:1;
         unsigned int URXREG1:1;
         unsigned int URXREG2:1;
         unsigned int URXREG3:1;
         unsigned int URXREG4:1;
         unsigned int URXREG5:1;
         unsigned int URXREG6:1;
         unsigned int URXREG7:1;
         unsigned int URXREG8:1;
      };
      struct {
         unsigned int URXREG:9;
      };
} U3RXREG;
#word U3RXREG = 0x256

#word U3BRG = 0x258

union  {
      struct {
         unsigned int SPIRBF:1;
         unsigned int SPITBF:1;
         unsigned int SISEL0:1;
         unsigned int SISEL1:1;
         unsigned int SISEL2:1;
         unsigned int SRXMPT:1;
         unsigned int SPIROV:1;
         unsigned int SRMPT:1;
         unsigned int SPIBEC0:1;
         unsigned int SPIBEC1:1;
         unsigned int SPIBEC2:1;
         unsigned int :2;
         unsigned int SPISIDL:1;
         unsigned int :1;
         unsigned int SPIEN:1;
      };
      struct {
         unsigned int :1;
         unsigned int :1;
         unsigned int SISEL:3;
         unsigned int :1;
         unsigned int :1;
         unsigned int :1;
         unsigned int SPIBEC:3;
         unsigned int :2;
         unsigned int :1;
         unsigned int :1;
         unsigned int :1;
      };
} SPI2STAT;
#word SPI2STAT = 0x260

union  {
      struct {
         unsigned int PPRE0:1;
         unsigned int PPRE1:1;
         unsigned int SPRE0:1;
         unsigned int SPRE1:1;
         unsigned int SPRE2:1;
         unsigned int MSTEN:1;
         unsigned int CKP:1;
         unsigned int SSEN:1;
         unsigned int CKE:1;
         unsigned int SMP:1;
         unsigned int MODE:1;
         unsigned int DISSDO:1;
         unsigned int DISSCK:1;
      };
      struct {
         unsigned int PPRE:2;
         unsigned int SPRE:3;
         unsigned int :1;
         unsigned int :1;
         unsigned int :1;
         unsigned int :1;
         unsigned int :1;
         unsigned int :1;
         unsigned int :1;
         unsigned int :1;
      };
} SPI2CON1;
#word SPI2CON1 = 0x262

struct  {
   unsigned int SPIBEN:1;
   unsigned int SPIFE:1;
   unsigned int :11;
   unsigned int SPIFPOL:1;
   unsigned int SPIFSD:1;
   unsigned int FRMEN:1;
} SPI2CON2;
#word SPI2CON2 = 0x264

#word SPI2BUF = 0x268

#word I2C3RCV = 0x270

#word I2C3TRN = 0x272

#word I2C3BRG = 0x274

struct  {
   unsigned int SEN:1;
   unsigned int RSEN:1;
   unsigned int PEN:1;
   unsigned int RCEN:1;
   unsigned int ACKEN:1;
   unsigned int ACKDT:1;
   unsigned int STREN:1;
   unsigned int GCEN:1;
   unsigned int SMEN:1;
   unsigned int DISSLW:1;
   unsigned int A10M:1;
   unsigned int IPMIEN:1;
   unsigned int SCLREL:1;
   unsigned int I2CSIDL:1;
   unsigned int :1;
   unsigned int I2CEN:1;
} I2C3CON;
#word I2C3CON = 0x276

struct  {
   union {
      struct {
         unsigned int TBF:1;
         unsigned int RBF:1;
         unsigned int R:1;
         unsigned int S:1;
         unsigned int P:1;
         unsigned int D:1;
         unsigned int I2COV:1;
         unsigned int IWCOL:1;
         unsigned int ADD:1;
         unsigned int GCSTAT:1;
         unsigned int BCL:1;
         unsigned int :3;
         unsigned int TRSTAT:1;
         unsigned int ACKSTAT:1;
      };

   union {
      struct {
         unsigned int :2;
         unsigned int R_W:1;
         unsigned int :2;
         unsigned int D_A:1;
      };
   };

      struct {
         unsigned int TBF:1;
         unsigned int RBF:1;
         unsigned int R:1;
         unsigned int S:1;
         unsigned int P:1;
         unsigned int D:1;
         unsigned int I2COV:1;
         unsigned int IWCOL:1;
         unsigned int ADD:1;
         unsigned int GCSTAT:1;
         unsigned int BCL:1;
         unsigned int :3;
         unsigned int TRSTAT:1;
         unsigned int ACKSTAT:1;
      };
   };
} I2C3STAT;
#word I2C3STAT = 0x278

#word I2C3ADD = 0x27A

#word I2C3MSK = 0x27C

union  {
      struct {
         unsigned int SPIRBF:1;
         unsigned int SPITBF:1;
         unsigned int SISEL0:1;
         unsigned int SISEL1:1;
         unsigned int SISEL2:1;
         unsigned int SRXMPT:1;
         unsigned int SPIROV:1;
         unsigned int SRMPT:1;
         unsigned int SPIBEC0:1;
         unsigned int SPIBEC1:1;
         unsigned int SPIBEC2:1;
         unsigned int :2;
         unsigned int SPISIDL:1;
         unsigned int :1;
         unsigned int SPIEN:1;
      };
      struct {
         unsigned int :1;
         unsigned int :1;
         unsigned int SISEL:3;
         unsigned int :1;
         unsigned int :1;
         unsigned int :1;
         unsigned int SPIBEC:3;
         unsigned int :2;
         unsigned int :1;
         unsigned int :1;
         unsigned int :1;
      };
} SPI3STAT;
#word SPI3STAT = 0x280

union  {
      struct {
         unsigned int PPRE0:1;
         unsigned int PPRE1:1;
         unsigned int SPRE0:1;
         unsigned int SPRE1:1;
         unsigned int SPRE2:1;
         unsigned int MSTEN:1;
         unsigned int CKP:1;
         unsigned int SSEN:1;
         unsigned int CKE:1;
         unsigned int SMP:1;
         unsigned int MODE:1;
         unsigned int DISSDO:1;
         unsigned int DISSCK:1;
      };
      struct {
         unsigned int PPRE:2;
         unsigned int SPRE:3;
         unsigned int :1;
         unsigned int :1;
         unsigned int :1;
         unsigned int :1;
         unsigned int :1;
         unsigned int :1;
         unsigned int :1;
         unsigned int :1;
      };
} SPI3CON1;
#word SPI3CON1 = 0x282

struct  {
   unsigned int SPIBEN:1;
   unsigned int SPIFE:1;
   unsigned int :11;
   unsigned int SPIFPOL:1;
   unsigned int SPIFSD:1;
   unsigned int FRMEN:1;
} SPI3CON2;
#word SPI3CON2 = 0x284

#word SPI3BUF = 0x288

union  {
      struct {
         unsigned int STSEL:1;
         unsigned int PDSEL0:1;
         unsigned int PDSEL1:1;
         unsigned int BRGH:1;
         unsigned int RXINV:1;
         unsigned int ABAUD:1;
         unsigned int LPBACK:1;
         unsigned int WAKE:1;
         unsigned int UEN0:1;
         unsigned int UEN1:1;
         unsigned int :1;
         unsigned int RTSMD:1;
         unsigned int IREN:1;
         unsigned int USIDL:1;
         unsigned int :1;
         unsigned int UARTEN:1;
      };
      struct {
         unsigned int :1;
         unsigned int PDSEL:2;
         unsigned int :1;
         unsigned int :1;
         unsigned int :1;
         unsigned int :1;
         unsigned int :1;
         unsigned int UEN:2;
         unsigned int :1;
         unsigned int :1;
         unsigned int :1;
         unsigned int :1;
         unsigned int :1;
         unsigned int :1;
      };
} U4MODE;
#word U4MODE = 0x2B0

union  {
      struct {
         unsigned int URXDA:1;
         unsigned int OERR:1;
         unsigned int FERR:1;
         unsigned int PERR:1;
         unsigned int RIDLE:1;
         unsigned int ADDEN:1;
         unsigned int URXISEL0:1;
         unsigned int URXISEL1:1;
         unsigned int TRMT:1;
         unsigned int UTXBF:1;
         unsigned int UTXEN:1;
         unsigned int UTXBRK:1;
         unsigned int :1;
         unsigned int UTXISEL0:1;
         unsigned int UTXINV:1;
         unsigned int UTXISEL1:1;
      };
      struct {
         unsigned int :1;
         unsigned int :1;
         unsigned int :1;
         unsigned int :1;
         unsigned int :1;
         unsigned int :1;
         unsigned int URXISEL:2;
         unsigned int :1;
         unsigned int :1;
         unsigned int :1;
         unsigned int :1;
         unsigned int :1;
         unsigned int UTXISEL:1;
         unsigned int :1;
         unsigned int :1;
      };
} U4STA;
#word U4STA = 0x2B2

union  {
      struct {
         unsigned int UTXREG0:1;
         unsigned int UTXREG1:1;
         unsigned int UTXREG2:1;
         unsigned int UTXREG3:1;
         unsigned int UTXREG4:1;
         unsigned int UTXREG5:1;
         unsigned int UTXREG6:1;
         unsigned int UTXREG7:1;
         unsigned int UTXREG8:1;
      };
      struct {
         unsigned int UTXREG:9;
      };
} U4TXREG;
#word U4TXREG = 0x2B4

union  {
      struct {
         unsigned int URXREG0:1;
         unsigned int URXREG1:1;
         unsigned int URXREG2:1;
         unsigned int URXREG3:1;
         unsigned int URXREG4:1;
         unsigned int URXREG5:1;
         unsigned int URXREG6:1;
         unsigned int URXREG7:1;
         unsigned int URXREG8:1;
      };
      struct {
         unsigned int URXREG:9;
      };
} U4RXREG;
#word U4RXREG = 0x2B6

#word U4BRG = 0x2B8

union  {
      struct {
         unsigned int TRISA0:1;
         unsigned int TRISA1:1;
         unsigned int TRISA2:1;
         unsigned int TRISA3:1;
         unsigned int TRISA4:1;
         unsigned int TRISA5:1;
         unsigned int TRISA6:1;
         unsigned int TRISA7:1;
         unsigned int :1;
         unsigned int TRISA9:1;
         unsigned int TRISA10:1;
         unsigned int :3;
         unsigned int TRISA14:1;
         unsigned int TRISA15:1;
      };
      struct {
         unsigned int TRISA:8;
         unsigned int :1;
         unsigned int :2;
         unsigned int :3;
         unsigned int :2;
      };
} TRISA;
#word TRISA = 0x2C0

union  {
      struct {
         unsigned int RA0:1;
         unsigned int RA1:1;
         unsigned int RA2:1;
         unsigned int RA3:1;
         unsigned int RA4:1;
         unsigned int RA5:1;
         unsigned int RA6:1;
         unsigned int RA7:1;
         unsigned int :1;
         unsigned int RA9:1;
         unsigned int RA10:1;
         unsigned int :3;
         unsigned int RA14:1;
         unsigned int RA15:1;
      };
      struct {
         unsigned int RA:8;
         unsigned int :1;
         unsigned int :2;
         unsigned int :3;
         unsigned int :2;
      };
} PORTA;
#word PORTA = 0x2C2

union  {
      struct {
         unsigned int LATA0:1;
         unsigned int LATA1:1;
         unsigned int LATA2:1;
         unsigned int LATA3:1;
         unsigned int LATA4:1;
         unsigned int LATA5:1;
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
         unsigned int RG13:1;
         unsigned int RG14:1;
         unsigned int RG15:1;
      };
      struct {
         unsigned int RG:4;
         unsigned int :2;
         unsigned int :4;
         unsigned int :2;
         unsigned int :4;
      };
} PORTG;
#word PORTG = 0x2F2

union  {
      struct {
         unsigned int LATG0:1;
         unsigned int LATG1:1;
         unsigned int LATG2:1;
         unsigned int LATG3:1;
         unsigned int :2;
         unsigned int LATG6:1;
         unsigned int LATG7:1;
         unsigned int LATG8:1;
         unsigned int LATG9:1;
         unsigned int :2;
         unsigned int LATG12:1;
         unsigned int LATG13:1;
         unsigned int LATG14:1;
         unsigned int LATG15:1;
      };
      struct {
         unsigned int LATG:4;
         unsigned int :2;
         unsigned int :4;
         unsigned int :2;
         unsigned int :4;
      };
} LATG;
#word LATG = 0x2F4

union  {
      struct {
         unsigned int ODG0:1;
         unsigned int ODG1:1;
         unsigned int ODG2:1;
         unsigned int ODG3:1;
         unsigned int :2;
         unsigned int ODG6:1;
         unsigned int ODG7:1;
         unsigned int ODG8:1;
         unsigned int ODG9:1;
         unsigned int :2;
         unsigned int ODG12:1;
         unsigned int ODG13:1;
         unsigned int ODG14:1;
         unsigned int ODG15:1;
      };
      struct {
         unsigned int ODG:4;
         unsigned int :2;
         unsigned int :4;
         unsigned int :2;
         unsigned int :4;
      };
} ODCG;
#word ODCG = 0x2F6

struct  {
   union {
      struct {
         unsigned int PMPTTL:1;
         unsigned int RTSECSEL:1;
      };

      struct {
         unsigned int :1;
         unsigned int RTSECSEL0:1;
      };
   };
} PADCFG1;
#word PADCFG1 = 0x2FC

#word ADC1BUF0 = 0x300

#word ADC1BUF1 = 0x302

#word ADC1BUF2 = 0x304

#word ADC1BUF3 = 0x306

#word ADC1BUF4 = 0x308

#word ADC1BUF5 = 0x30A

#word ADC1BUF6 = 0x30C

#word ADC1BUF7 = 0x30E

#word ADC1BUF8 = 0x310

#word ADC1BUF9 = 0x312

#word ADC1BUFA = 0x314

#word ADC1BUFB = 0x316

#word ADC1BUFC = 0x318

#word ADC1BUFD = 0x31A

#word ADC1BUFE = 0x31C

#word ADC1BUFF = 0x31E

union  {
      struct {
         unsigned int DONE:1;
         unsigned int SAMP:1;
         unsigned int ASAM:1;
         unsigned int :2;
         unsigned int SSRC0:1;
         unsigned int SSRC1:1;
         unsigned int SSRC2:1;
         unsigned int FORM0:1;
         unsigned int FORM1:1;
         unsigned int :3;
         unsigned int ADSIDL:1;
         unsigned int :1;
         unsigned int ADON:1;
      };
      struct {
         unsigned int :1;
         unsigned int :1;
         unsigned int :1;
         unsigned int :2;
         unsigned int SSRC:3;
         unsigned int FORM:2;
         unsigned int :3;
         unsigned int :1;
         unsigned int :1;
         unsigned int :1;
      };
} AD1CON1;
#word AD1CON1 = 0x320

union  {
      struct {
         unsigned int ALTS:1;
         unsigned int BUFM:1;
         unsigned int SMPI0:1;
         unsigned int SMPI1:1;
         unsigned int SMPI2:1;
         unsigned int SMPI3:1;
         unsigned int :1;
         unsigned int BUFS:1;
         unsigned int :2;
         unsigned int CSCNA:1;
         unsigned int :1;
         unsigned int OFFCAL:1;
         unsigned int VCFG0:1;
         unsigned int VCFG1:1;
         unsigned int VCFG2:1;
      };
      struct {
         unsigned int :1;
         unsigned int :1;
         unsigned int SMPI:4;
         unsigned int :1;
         unsigned int :1;
         unsigned int :2;
         unsigned int :1;
         unsigned int :1;
         unsigned int :1;
         unsigned int VCFG:3;
      };
} AD1CON2;
#word AD1CON2 = 0x322

union  {
      struct {
         unsigned int ADCS0:1;
         unsigned int ADCS1:1;
         unsigned int ADCS2:1;
         unsigned int ADCS3:1;
         unsigned int ADCS4:1;
         unsigned int ADCS5:1;
         unsigned int ADCS6:1;
         unsigned int ADCS7:1;
         unsigned int SAMC0:1;
         unsigned int SAMC1:1;
         unsigned int SAMC2:1;
         unsigned int SAMC3:1;
         unsigned int SAMC4:1;
         unsigned int :2;
         unsigned int ADRC:1;
      };
      struct {
         unsigned int ADCS:8;
         unsigned int SAMC:5;
         unsigned int :2;
         unsigned int :1;
      };
} AD1CON3;
#word AD1CON3 = 0x324

union  {
      struct {
         unsigned int CH0SA0:1;
         unsigned int CH0SA1:1;
         unsigned int CH0SA2:1;
         unsigned int CH0SA3:1;
         unsigned int CH0SA4:1;
         unsigned int :2;
         unsigned int CH0NA:1;
         unsigned int CH0SB0:1;
         unsigned int CH0SB1:1;
         unsigned int CH0SB2:1;
         unsigned int CH0SB3:1;
         unsigned int CH0SB4:1;
         unsigned int :2;
         unsigned int CH0NB:1;
      };
      struct {
         unsigned int CH0SA:5;
         unsigned int :2;
         unsigned int :1;
         unsigned int CH0SB:5;
         unsigned int :2;
         unsigned int :1;
      };
} AD1CHS;
#word AD1CHS = 0x328

struct  {
   unsigned int PCFG0:1;
   unsigned int PCFG17:1;
} AD1PCFGH;
#word AD1PCFGH = 0x32A

union  {
      struct {
         unsigned int PCFG0:1;
         unsigned int PCFG1:1;
         unsigned int PCFG2:1;
         unsigned int PCFG3:1;
         unsigned int PCFG4:1;
         unsigned int PCFG5:1;
         unsigned int PCFG6:1;
         unsigned int PCFG7:1;
         unsigned int PCFG8:1;
         unsigned int PCFG9:1;
         unsigned int PCFG10:1;
         unsigned int PCFG11:1;
         unsigned int PCFG12:1;
         unsigned int PCFG13:1;
         unsigned int PCFG14:1;
         unsigned int PCFG15:1;
      };
      struct {
         unsigned int PCFG:16;
      };
} AD1PCFGL;
#word AD1PCFGL = 0x32C

union  {
      struct {
         unsigned int CSSL0:1;
         unsigned int CSSL1:1;
         unsigned int CSSL2:1;
         unsigned int CSSL3:1;
         unsigned int CSSL4:1;
         unsigned int CSSL5:1;
         unsigned int CSSL6:1;
         unsigned int CSSL7:1;
         unsigned int CSSL8:1;
         unsigned int CSSL9:1;
         unsigned int CSSL10:1;
         unsigned int CSSL11:1;
         unsigned int CSSL12:1;
         unsigned int CSSL13:1;
         unsigned int CSSL14:1;
         unsigned int CSSL15:1;
      };
      struct {
         unsigned int CSSL:16;
      };
} AD1CSS;
#word AD1CSSL = 0x330

struct  {
   unsigned int CSSL0:1;
   unsigned int CSSL17:1;
} AD1CSSH;
#word AD1CSSH = 0x332

union  {
      struct {
         unsigned int EDG1STAT:1;
         unsigned int EDG2STAT:1;
         unsigned int EDG1SEL0:1;
         unsigned int EDG1SEL1:1;
         unsigned int EDG1POL:1;
         unsigned int EDG2SEL0:1;
         unsigned int EDG2SEL1:1;
         unsigned int EDG2POL:1;
         unsigned int CTTRIG:1;
         unsigned int IDISSEN:1;
         unsigned int EDGSEQEN:1;
         unsigned int EDGEN:1;
         unsigned int TGEN:1;
         unsigned int CTMUSIDL:1;
         unsigned int :1;
         unsigned int CTMUEN:1;
      };
      struct {
         unsigned int :1;
         unsigned int :1;
         unsigned int EDG1SEL:2;
         unsigned int :1;
         unsigned int EDG2SEL:2;
         unsigned int :1;
         unsigned int :1;
         unsigned int :1;
         unsigned int :1;
         unsigned int :1;
         unsigned int :1;
         unsigned int :1;
         unsigned int :1;
         unsigned int :1;
      };
} CTMUCON;
#word CTMUCON = 0x33C

union  {
      struct {
         unsigned int :8;
         unsigned int IRNG0:1;
         unsigned int IRNG1:1;
         unsigned int ITRIM0:1;
         unsigned int ITRIM1:1;
         unsigned int ITRIM2:1;
         unsigned int ITRIM3:1;
         unsigned int ITRIM4:1;
         unsigned int ITRIM5:1;
      };
      struct {
         unsigned int :8;
         unsigned int IRNG:2;
         unsigned int ITRIM:6;
      };
} CTMUICON;
#word CTMUICON = 0x33E

struct  {
   unsigned int VBUSVDIF:1;
   unsigned int :1;
   unsigned int SESENDIF:1;
   unsigned int SESVDIF:1;
   unsigned int ACTVIF:1;
   unsigned int LSTATEIF:1;
   unsigned int T1MSECIF:1;
   unsigned int IDIF:1;
} U1OTGIR;
#word U1OTGIR = 0x480

struct  {
   unsigned int VBUSVDIE:1;
   unsigned int :1;
   unsigned int SESENDIE:1;
   unsigned int SESVDIE:1;
   unsigned int ACTVIE:1;
   unsigned int LSTATEIE:1;
   unsigned int T1MSECIE:1;
   unsigned int IDIE:1;
} U1OTGIE;
#word U1OTGIE = 0x482

struct  {
   unsigned int VBUSVD:1;
   unsigned int :1;
   unsigned int SESEND:1;
   unsigned int SESVD:1;
   unsigned int :1;
   unsigned int LSTATE:1;
   unsigned int :1;
   unsigned int ID:1;
} U1OTGSTAT;
#word U1OTGSTAT = 0x484

struct  {
   unsigned int VBUSDIS:1;
   unsigned int VBUSCHG:1;
   unsigned int OTGEN:1;
   unsigned int VBUSON:1;
   unsigned int DMPULDWN:1;
   unsigned int DPPULDWN:1;
   unsigned int DMPULUP:1;
   unsigned int DPPULUP:1;
} U1OTGCON;
#word U1OTGCON = 0x486

struct  {
   union {
      struct {
         unsigned int USBPWR:1;
         unsigned int USUSPEND:1;
         unsigned int :2;
         unsigned int USLPGRD:1;
         unsigned int :2;
         unsigned int UACTPND:1;
      };

      struct {
         unsigned int :1;
         unsigned int USUSPND:1;
      };
   };
} U1PWRC;
#word U1PWRC = 0x488

struct  {
   union {
      struct {
         unsigned int URSTIF:1;
         unsigned int UERRIF:1;
         unsigned int SOFIF:1;
         unsigned int TRNIF:1;
         unsigned int IDLEIF:1;
         unsigned int RESUMEIF:1;
         unsigned int ATTACHIF:1;
         unsigned int STALLIF:1;
      };

      struct {
         unsigned int DETACHIF:1;
      };
   };
} U1IR;
#word U1IR = 0x48A

struct  {
   union {
      struct {
         unsigned int URSTIE:1;
         unsigned int UERRIE:1;
         unsigned int SOFIE:1;
         unsigned int TRNIE:1;
         unsigned int IDLEIE:1;
         unsigned int RESUMEIE:1;
         unsigned int ATTACHIE:1;
         unsigned int STALLIE:1;
      };

      struct {
         unsigned int DETACHIE:1;
      };
   };
} U1IE;
#word U1IE = 0x48C

struct  {
   union {
      struct {
         unsigned int PIDEF:1;
         unsigned int CRC5EF:1;
         unsigned int CRC16EF:1;
         unsigned int DFN8EF:1;
         unsigned int BTOEF:1;
         unsigned int DMAEF:1;
         unsigned int :1;
         unsigned int BTSEF:1;
      };

      struct {
         unsigned int :1;
         unsigned int EOFEF:1;
      };
   };
} U1EIR;
#word U1EIR = 0x48E

struct  {
   union {
      struct {
         unsigned int PIDEE:1;
         unsigned int CRC5EE:1;
         unsigned int CRC16EE:1;
         unsigned int DFN8EE:1;
         unsigned int BTOEE:1;
         unsigned int DMAEE:1;
         unsigned int :1;
         unsigned int BTSEE:1;
      };

      struct {
         unsigned int :1;
         unsigned int EOFEE:1;
      };
   };
} U1EIE;
#word U1EIE = 0x490

union  {
      struct {
         unsigned int :2;
         unsigned int PPBI:1;
         unsigned int DIR:1;
         unsigned int ENDPT0:1;
         unsigned int ENDPT1:1;
         unsigned int ENDPT2:1;
         unsigned int ENDPT3:1;
      };
      struct {
         unsigned int :2;
         unsigned int :1;
         unsigned int :1;
         unsigned int ENDPT:4;
      };
} U1STAT;
#word U1STAT = 0x492

struct  {
   union {
      struct {
         unsigned int USBEN:1;
         unsigned int PPBRST:1;
         unsigned int RESUME:1;
         unsigned int HOSTEN:1;
         unsigned int RESET:1;
         unsigned int PKTDIS:1;
         unsigned int SE:1;
         unsigned int JSTATE:1;
      };

      struct {
         unsigned int SOFEN:1;
         unsigned int :3;
         unsigned int USBRST:1;
         unsigned int TOKBUSY:1;
      };
   };
} U1CON;
#word U1CON = 0x494

union  {
   union {
      struct {
         unsigned int ADDR0:1;
         unsigned int ADDR1:1;
         unsigned int ADDR2:1;
         unsigned int ADDR3:1;
         unsigned int ADDR4:1;
         unsigned int ADDR5:1;
         unsigned int ADDR6:1;
         unsigned int LSPDEN:1;
      };
      struct {
         unsigned int ADDR:7;
         unsigned int :1;
      };

      struct {
         unsigned int DEVADDR0:1;
         unsigned int DEVADDR1:1;
         unsigned int DEVADDR2:1;
         unsigned int DEVADDR3:1;
         unsigned int DEVADDR4:1;
         unsigned int DEVADDR5:1;
         unsigned int DEVADDR6:1;
         unsigned int LOWSPDEN:1;
      };
   };
      struct {
         unsigned int DEVADDR:7;
         unsigned int :1;
      };
} U1ADDR;
#word U1ADDR = 0x496

struct  {
   union {
      struct {
         unsigned int :1;
         unsigned int BDTBA0:1;
         unsigned int BDTBA1:1;
         unsigned int BDTBA2:1;
         unsigned int BDTBA3:1;
         unsigned int BDTBA4:1;
         unsigned int BDTBA5:1;
         unsigned int BDTBA15:1;
      };

      struct {
         unsigned int :1;
         unsigned int BDTPTRL0:1;
         unsigned int BDTPTRL1:1;
         unsigned int BDTPTRL2:1;
         unsigned int BDTPTRL3:1;
         unsigned int BDTPTRL4:1;
         unsigned int BDTPTRL5:1;
         unsigned int BDTPTRL6:1;
      };
   };
      struct {
         unsigned int :1;
         unsigned int BDTPTRL:7;
      };
} U1BDTP1;
#word U1BDTP1 = 0x498

union  {
      struct {
         unsigned int FRM0:1;
         unsigned int FRM1:1;
         unsigned int FRM2:1;
         unsigned int FRM3:1;
         unsigned int FRM4:1;
         unsigned int FRM5:1;
         unsigned int FRM6:1;
         unsigned int FRM7:1;
      };
      struct {
         unsigned int FRM:8;
      };
} U1FRM;
#word U1FRML = 0x49A

struct  {
   unsigned int FRM0:1;
   unsigned int FRM1:1;
   unsigned int FRM2:1;
   unsigned int FRM3:1;
   unsigned int FRM4:1;
   unsigned int FRM5:1;
   unsigned int FRM6:1;
   unsigned int FRM15:1;
} U1FRMH;
#word U1FRMH = 0x49C

union  {
      struct {
         unsigned int EP0:1;
         unsigned int EP1:1;
         unsigned int EP2:1;
         unsigned int EP3:1;
         unsigned int PID0:1;
         unsigned int PID1:1;
         unsigned int PID2:1;
         unsigned int PID3:1;
      };
      struct {
         unsigned int EP:4;
         unsigned int PID:4;
      };
} U1TOK;
#word U1TOK = 0x49E

union  {
      struct {
         unsigned int CNT0:1;
         unsigned int CNT1:1;
         unsigned int CNT2:1;
         unsigned int CNT3:1;
         unsigned int CNT4:1;
         unsigned int CNT5:1;
         unsigned int CNT6:1;
         unsigned int CNT7:1;
      };
      struct {
         unsigned int CNT:8;
      };
} U1SOF;
#word U1SOF = 0x4A0

union  {
      struct {
         unsigned int PPB0:1;
         unsigned int PPB1:1;
         unsigned int :2;
         unsigned int USBSIDL:1;
         unsigned int :1;
         unsigned int UOEMON:1;
         unsigned int UTEYE:1;
      };
      struct {
         unsigned int PPB:2;
         unsigned int :2;
         unsigned int :1;
         unsigned int :1;
         unsigned int :1;
         unsigned int :1;
      };
} U1CNFG1;
#word U1CNFG1 = 0x4A6

struct  {
   unsigned int UTRDIS:1;
   unsigned int UVCMPDIS:1;
   unsigned int UVBUSDIS:1;
   unsigned int EXTI2CEN:1;
   unsigned int PUVBUS:1;
} U1CNFG2;
#word U1CNFG2 = 0x4A8

struct  {
   union {
      struct {
         unsigned int EPHSHK:1;
         unsigned int EPSTALL:1;
         unsigned int EPTXEN:1;
         unsigned int EPRXEN:1;
         unsigned int EPCONDIS:1;
         unsigned int :1;
         unsigned int RETRYDIS:1;
         unsigned int LSPD:1;
      };

      struct {
         unsigned int :2;
         unsigned int EPINEN:1;
         unsigned int EPOUTEN:1;
         unsigned int :3;
         unsigned int LOWSPD:1;
      };
   };
} U1EP0;
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
         unsigned int EPSTALL:1;
         unsigned int EPTXEN:1;
         unsigned int EPRXEN:1;
         unsigned int EPCONDIS:1;
      };

      struct {
         unsigned int :2;
         unsigned int EPINEN:1;
         unsigned int EPOUTEN:1;
      };
   };
} U1EP10;
#word U1EP10 = 0x4BE
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
