ABMicrowaves/Project_1410/(commit log)

2018-02-04 Project 1410:
    Commit fixes:
    a. First commit to GIT.
    [verilog.psm]
2018-02-20 Commit fixes:
    a. Upload latest version from Asaf.
    [BA1410RX10R3_2.DSN, SOQPSK_TX_BB_A0P28.DSN, verilog.psm]
2018-02-22 Commit fixes:
    a. Change in data polarity (oposite states).
    b. Change in BG paramater (instead: num of packets in 1 sec, it calculate frequancies of packets).
    [BA1410TX.c, BA1410TX_serial.c]
